ipkeys/eisscubeLTEhardware/kicad/Design-doc/EISScube v3.0 LTE 3D-front.jpg

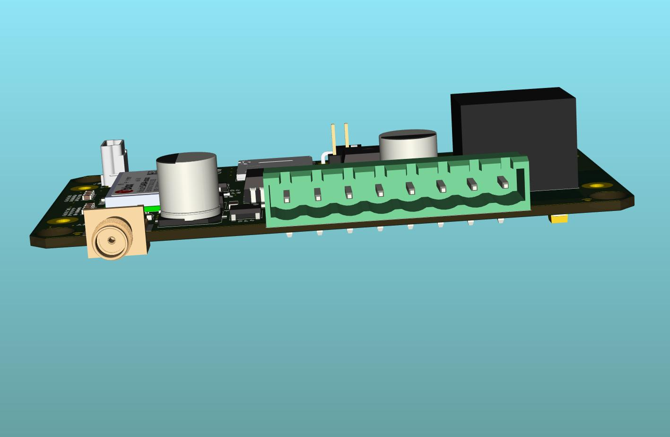
kicad/Design-doc/EISScube v3.0 LTE 3D-front.jpg
