ipkeys/eisscubeLTEhardware/README.md

# eisscubeLTEhardware
EISScube v3.0 LTE hardware design
