ipkeys/eisscubeLTEhardware/kicad/Design-doc/EISScube v3.0 LTE-BOM-case-connector.xlsx

Source: | EISScube v3.0 LTE.sch
Date: | Wednesday, April 18, 2018 'PMt' 01:15:05 PM
Tool: | Eeschema 4.0.7
Component Count: | 126
Ref | Qnty | Value | Footprint | Description
AE1, | 1 | Antenna_Shield | Connectors_Molex:Molex_SMA_Jack_Edge_Mount | SMA Jack (edge mount)
C1, C7, C8, C9, C10, C11, C6, C21, C18, C20, C31, | 11 | 104K | Capacitors_SMD:C_0603 | Unpolarized capacitor
C4, C5, C2, C3, | 4 | 220J | Capacitors_SMD:C_0603 | Unpolarized capacitor
C12, | 1 | 330J | Capacitors_SMD:C_0603 | Unpolarized capacitor
C13, | 1 | 270J | Capacitors_SMD:C_0603 | Unpolarized capacitor
C14, C15, | 2 | 150J | Capacitors_SMD:C_0603 | Unpolarized capacitor
C16, | 1 | 680J | Capacitors_SMD:C_0603 | Unpolarized capacitor
C17, | 1 | 103K | Capacitors_SMD:C_0603 | Unpolarized capacitor
C19, C39, C42, | 3 | 105K | Capacitors_SMD:C_0603 | Unpolarized capacitor
C27, C26, C22, C23, C24, C25, | 6 | 470J | Capacitors_SMD:C_0603 | Unpolarized capacitor
C28, | 1 | 220uF 35V | Capacitors_SMD:CP_Elec_10x10.5 | Polarised capacitor
C30, | 1 | 470uF 16V | Capacitors_SMD:CP_Elec_10x10.5 | Polarised capacitor
C32, C35, | 2 | 106K 16V | Capacitors_Tantalum_SMD:CP_Tantalum_Case-B_EIA-3528-21_Reflow | Polarised capacitor
C34, C37, C38, C40, C41, C43, | 6 | 106K 6V3 | Capacitors_Tantalum_SMD:CP_Tantalum_Case-A_EIA-3216-18_Reflow | Polarised capacitor
C36, C33, C29, | 3 | 105K | Capacitors_SMD:C_1206 | Unpolarized capacitor
D1, D2, D3, D4, D5, | 5 | blue | LEDs:LED_0603 | LED generic
D6, D7, D8, D9, D10, D11, D12, | 7 | VBUS05B1-SD0 | Diodes_SMD:D_0603 | ESD Suppressors / TVS Diodes BiSy Sngl Line 5.5V ESD Prot Diode 16kV
D14, | 1 | MBL104S | Diodes_SMD:Diode_Bridge_MBLS | Diode Bridge
D15, | 1 | B120-E3 | Diodes_SMD:D_SMA | Surface Mount Schottky Barrier Rectifier
D17, D13, D16, | 3 | red | LEDs:LED_0603 | LED generic
D18, | 1 | 1N4001 | Diodes_THT:D_DO-41_SOD81_P10.16mm_Horizontal | Diod generic
J1, | 1 | Boot | Pin_Headers:Pin_Header_Straight_1x02_Pitch2.54mm | Generic connector, single row, 01x02
J2, | 1 | UART | Pin_Headers:Pin_Header_Straight_1x03_Pitch2.54mm | Generic connector, single row, 01x03
J3, | 1 | JTag | Socket_Strips:Socket_Strip_Straight_1x05_Pitch2.54mm | Generic connector, single row, 01x05
J4, | 1 | SIM_Card_w_det_sw | EISScube_LTE:SIM_Card_Hirose_KP10S-SF-PEJ-812 | SIM Card push-push holder with detect switch
J5, | 1 | USB_B_Mini | EISScube_LTE:USB_Micro-B_Molex-5022370517_Vertical | USB Mini Type B connector
J6, | 1 | Screw_Terminal_01x08 | Connectors_Phoenix:PhoenixContact_MSTBA-G_08x5.08mm_Angled | Phoenix Contact MSTBA-G_08
K1, | 1 | SANYOU_SRD_Form_C | Relays_THT:Relay_SPDT_SANYOU_SRD_Series_Form_C | Relay Song Chuan 833H-1C-C-12VDC
L1, | 1 | 68nH | Inductors_SMD:L_0603 | Inductor generic
L2, | 1 | 39nH | Inductors_SMD:L_0603 | Inductor generic
L3, | 1 | 150uH | Inductors_SMD:L_10.4x10.4_H4.8 | Inductor power
Q3, Q4, Q2, Q5, | 4 | GSM3612PJZF | TO_SOT_Packages_SMD:SOT-23 | Transistor N-MOSFETwith substrate diode (general)
R1, | 1 | 100K | Resistors_SMD:R_0603 | Resistor generic
R2, | 1 | 1K | Resistors_SMD:R_1206 | Resistor generic
R3, | 1 | 510R | Resistors_SMD:R_0603 | Resistor generic
R6, | 1 | 240R | Resistors_SMD:R_0603 | Resistor generic
R7, R8, R9, R10, R11, R4, R21, R22, R27, R25, R20, R29, R28, | 13 | 1K | Resistors_SMD:R_0603 | Resistor generic
R12, R13, R14, | 3 | 10K | Resistors_SMD:R_0603 | Resistor generic
R16, | 1 | 470K | Resistors_SMD:R_0603 | Resistor generic
R24, R26, R23, R19, R18, R17, R15, | 7 | 0R | Resistors_SMD:R_0603 | Resistor generic
R30, | 1 | 30K | Resistors_SMD:R_0603 | Resistor generic
R31, | 1 | 15K | Resistors_SMD:R_0603 | Resistor generic
SW1, | 1 | Reset | Buttons_Switches_SMD:SW_SPST_PTS645 | Push button switch, generic, 4 pins
TP1, TP2, TP7, TP6, TP8, TP3, TP4, TP5, | 8 | Test_Point | Connectors_TestPoints:Test_Point_Pad_d1.0mm | test point
U1, | 1 | STM32L051C8Tx | Housings_QFP:LQFP-48_7x7mm_Pitch0.5mm | Core: ARM Cortex-M0+, Package: LQFP48, Flash: 32 kB, RAM: 8 kB, Frequency: 32 MHz, Voltage: 1.65..3.6V, I/O pins: 37
U2, | 1 | SN74LV1T34DBVR | TO_SOT_Packages_SMD:SOT-23-5 | Single Power Supply Single Buffer GATE CMOS Logic Level Shifter
U3, | 1 | U-Blox-SARA-R4 | EISScube_LTE:SARA-R4-96 | LTE Cat M1/NB1 and EGPRS modules - SARA-R410M-02B-00, SARA-R410M-01B-00, SARA-R404M-00B
U4, | 1 | LM2576HVS-12 | TO_SOT_Packages_SMD:TO-263-5_TabPin3 | TO-263, 12V 3A Step-Down VR High Voltage Input
U5, | 1 | MIC29302WU-TR | TO_SOT_Packages_SMD:TO-263-5_TabPin6 | High-Current Low Dropout Regulators
U6, | 1 | L7805 | TO_SOT_Packages_SMD:TO-252-2 | Positive 1.5A 35V Linear Regulator, Fixed Output 5V
U7, | 1 | LM1117-3.3 | TO_SOT_Packages_SMD:SOT-223-3_TabPin2 | 800mA Low-Dropout Linear Regulator, 3.3V fixed output
U8, | 1 | LM1117-1.8 | TO_SOT_Packages_SMD:SOT-223-3_TabPin2 | 800mA Low-Dropout Linear Regulator, 1.8V fixed output
U9, | 1 | LTV-357T | Housings_SOIC:SO-4_4.4x3.6mm_Pitch2.54mm | DC Optocoupler, Vce 80V, CTR 50%
Y1, | 1 | 12MHz | Crystals:Crystal_SMD_3225-4pin_3.2x2.5mm | Four pin crystal (GND on pins 2 and 4), e.g. in SMD package
Y2, | 1 | 32.768KHz | Crystals:Crystal_SMD_3215-2pin_3.2x1.5mm | Two pin crystal
External | 1 | Screw_Terminal_01x08 second part | PhoenixContact_MSTB 2,5/ 2-ST-5,08 | Plug component, Screw connection with tension sleeve Phoenix Contact MSTB 2-ST-5,08
External | 1 | Case | RITEC Enclosures - RL6015 | Clousure case (need to ask for customization - make a 4 holes in bottom part)
