ipkeys/eisscubeLTEhardware/kicad/Design-doc/EISScube v3.0 LTE-BOM.xlsx

Source: | /EISScube v3.0 LTE/EISScube v3.0 LTE.sch
Date: | Tuesday, April 03, 2018 'PMt' 01:28:19 PM
Tool: | Eeschema 4.0.7
Component Count: | 126 |  |  |  | Total: | 51.11
Ref | Qnty | Value | Cmp name | Vendor | Price (for 100 items) | Price for 1 board | Description
AE1, | 1 | Antenna_Shield | Antenna_Shield | Mouser Electronics | 2.67 | 2.67 | Antenna symbol with extra pin for shielding
C1, C7, C8, C9, C10, C11, C6, C21, C18, C20, C31, | 11 | 104K | C | Mouser Electronics | 0.03 | 0.33 | Unpolarized capacitor
C4, C5, C2, C3, | 4 | 220J | C | Mouser Electronics | 0.03 | 0.12 | Unpolarized capacitor
C12, | 1 | 330J | C | Mouser Electronics | 0.03 | 0.03 | Unpolarized capacitor
C13, | 1 | 270J | C | Mouser Electronics | 0.03 | 0.03 | Unpolarized capacitor
C14, C15, | 2 | 150J | C | Mouser Electronics | 0.03 | 0.06 | Unpolarized capacitor
C16, | 1 | 680J | C | Mouser Electronics | 0.03 | 0.03 | Unpolarized capacitor
C17, | 1 | 103K | C | Mouser Electronics | 0.02 | 0.02 | Unpolarized capacitor
C19, C39, C42, | 3 | 105K | C | Mouser Electronics | 0.03 | 0.09 | Unpolarized capacitor
C27, C26, C22, C23, C24, C25, | 6 | 470J | C | Mouser Electronics | 0.03 | 0.18 | Unpolarized capacitor
C28, | 1 | 470uF 35V | CP | Mouser Electronics | 0.52 | 0.52 | Polarised capacitor
C30, | 1 | 330uF 16V | CP | Mouser Electronics | 0.25 | 0.25 | Polarised capacitor
C32, C35 | 2 | 106K 16V | CP | Mouser Electronics | 1 | 2 | Polarised capacitor
C34, C37, C38, C40, C41, C43, | 6 | 106K 6V3 | CP | Mouser Electronics | 0.5 | 3 | Polarised capacitor
C29, C36, C33, | 3 | 105K | C | Mouser Electronics | 0.12 | 0.36 | Unpolarized capacitor
D1, D2, D3, D4, D5, | 5 | blue | LED | Mouser Electronics | 0.08 | 0.4 | LED generic
D6, D7, D8, D9, D10, D11, D12, | 7 | VBUS05B1-SD0 | VBUS05B1-SD0 | Mouser Electronics | 0.09 | 0.63 | ESD Suppressors / TVS Diodes BiSy Sngl Line 5.5V ESD Prot Diode 16kV
D14, | 1 | MBL104S | MBL104S | Mouser Electronics | 0.31 | 0.31
D15, | 1 | B120-E3 | B120-E3 | Mouser Electronics | 0.15 | 0.15
D17, D13, D16, | 3 | red | LED | Mouser Electronics | 0.08 | 0.24 | LED generic
D18, | 1 | 1N4001 | 1N4001 | Mouser Electronics | 0.25 | 0.25
J1, | 1 | Boot | Conn_01x02_Male | Mouser Electronics | 0.1 | 0.1 | Generic connector, single row, 01x02
J2, | 1 | UART | Conn_01x03_Male | Mouser Electronics | 0.1 | 0.1 | Generic connector, single row, 01x03
J3, | 1 | JTag | Conn_01x05_Female | Mouser Electronics | 0.1 | 0.1 | Generic connector, single row, 01x05
J4, | 1 | SIM_Card_w_det_sw | SIM_Card_w_det_sw | Mouser Electronics | 1.1 | 1.1 | SIM Card
J5, | 1 | USB_B_Mini | USB_B_Mini | Mouser Electronics | 2.26 | 2.26 | USB Mini Type B connector
J6, | 1 | Screw_Terminal_01x08 | Screw_Terminal_01x08 | Mouser Electronics | 2.5 | 2.5 | Generic screw terminal, single row, 01x08
K1, | 1 | SANYOU_SRD_Form_C | SANYOU_SRD_Form_C | Mouser Electronics | 1.5 | 1.5
L1, | 1 | 68nH | L | Mouser Electronics | 0.1 | 0.1 | Inductor
L2, | 1 | 39nH | L | Mouser Electronics | 0.1 | 0.1 | Inductor
L3, | 1 | 150uH | L | Mouser Electronics | 0.5 | 0.5 | Inductor
Q3, Q4, Q2, Q5, | 4 | GSM3612PJZF | Q_NMOS_GSD | Mouser Electronics | 0.1 | 0.4 | Transistor N-MOSFETwith substrate diode (general)
R1, | 1 | 100K | R | Mouser Electronics | 0.01 | 0.01 | Resistor
R2, | 1 | 1K | R | Mouser Electronics | 0.04 | 0.04 | Resistor
R3, | 1 | 510R | R | Mouser Electronics | 0.01 | 0.01 | Resistor
R6, | 1 | 240R | R | Mouser Electronics | 0.01 | 0.01 | Resistor
R7, R8, R9, R10, R11, R4, R21, R22, R27, R25, R20, R29, R28, | 13 | 1K | R | Mouser Electronics | 0.01 | 0.13 | Resistor
R12, R13, R14, | 3 | 10K | R | Mouser Electronics | 0.01 | 0.03 | Resistor
R16, | 1 | 470K | R | Mouser Electronics | 0.01 | 0.01 | Resistor
R24, R26, R23, R19, R18, R17, R15, | 7 | 0R | R | Mouser Electronics | 0.01 | 0.07 | Resistor
R30, | 1 | 30K | R | Mouser Electronics | 0.01 | 0.01 | Resistor
R31, | 1 | 15K | R | Mouser Electronics | 0.01 | 0.01 | Resistor
SW1, | 1 | Reset | SW_Push | Mouser Electronics | 0.2 | 0.2 | Push button switch, generic, two pins
TP1, TP2, TP7, TP6, TP8, TP3, TP4, TP5, | 8 | Test_Point | Test_Point | Mouser Electronics | 0 | 0 | test point
U1, | 1 | STM32L051C8Tx | STM32L051C8Tx | Mouser Electronics | 1.75 | 1.75 | Core: ARM Cortex-M0+, Package: LQFP48, Flash: 32 kB, RAM: 8 kB, Frequency: 32 MHz, Voltage: 1.65..3.6V, I/O pins: 37
U2, | 1 | SN74LV1T34DBVR | SN74LV1T34DBVR | Mouser Electronics | 0.2 | 0.2 | Single Power Supply Single Buffer GATE CMOS Logic Level Shifter
U3, | 1 | U-Blox-SARA-R4 | U-Blox-SARA-R4 | Mouser Electronics | 17 | 17 | Size-optimized LTE Cat M1/NB1 and EGPRS modules
U4, | 1 | LM2576HVS-12 | LM2576HVS-12 | Mouser Electronics | 6.5 | 6.5 | TO-263, 12V 3A Step-Down VR High Voltage Input
U5, | 1 | MIC29302WU-TR | MIC29302WU-TR | Mouser Electronics | 2.2 | 2.2
U6, | 1 | L7805 | L7805 | Mouser Electronics | 0.5 | 0.5 | Positive 1.5A 35V Linear Regulator, Fixed Output 5V, TO-220/TO-263/TO-252
U7, | 1 | LM1117-3.3 | LM1117-3.3 | Mouser Electronics | 0.5 | 0.5 | 800mA Low-Dropout Linear Regulator, 1.8V fixed output, TO-220/TO-252/TO-263/SOT-223
U8, | 1 | LM1117-1.8 | LM1117-1.8 | Mouser Electronics | 0.5 | 0.5 | 800mA Low-Dropout Linear Regulator, 1.8V fixed output, TO-220/TO-252/TO-263/SOT-223
U9, | 1 | LTV-357T | LTV-357T | Mouser Electronics | 0.5 | 0.5 | DC Optocoupler, Vce 80V, CTR 50%, SO-4
Y1, | 1 | 12MHz | Crystal_GND24 | Mouser Electronics | 0.3 | 0.3 | Four pin crystal (GND on pins 2 and 4), e.g. in SMD package
Y2, | 1 | 32.768KHz | Crystal | Mouser Electronics | 0.2 | 0.2 | Two pin crystal
