ipkeys/eisscubeLTEhardware/3D/RL6015 w1 151029.STEP

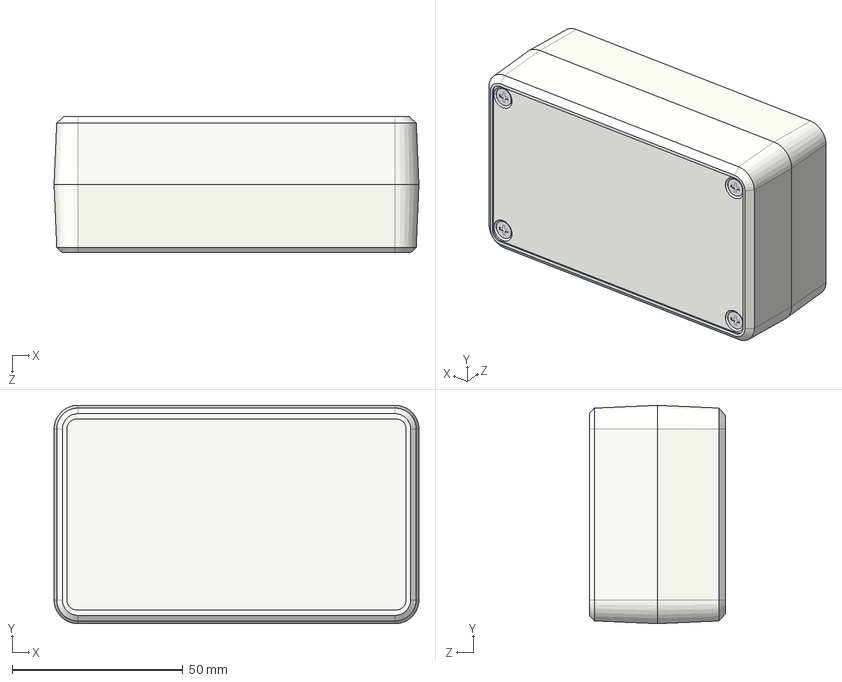
[picture p7: CAD file, 2018-05-07]
3D/RL6015 w1 151029.STEP
107.0 x 64.0 x 40.0 mm
6015B v1
6015T v1
FLAT M3-25-Self v2 x 4
M3x6-pan self x 4
