ipkeys/eisscubeLTEhardware/kicad/EISScube_v3_0_LTE.FCStd

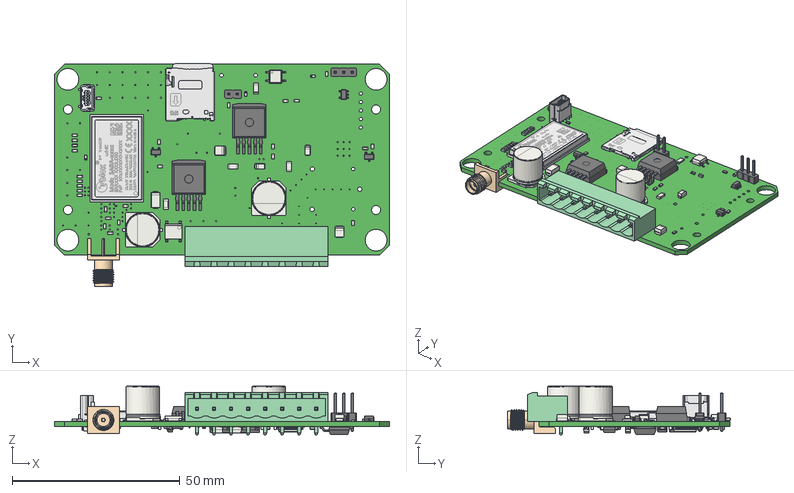
[picture p8: CAD file, 2018-05-07]
kicad/EISScube_v3_0_LTE.FCStd
100.0 x 66.4 x 14.5 mm
Pcb
R_0603_
C_0603_
C_1206_
C_1206_001
MSTBA_01x08_G_5_08mm_
Molex_SMA_Jack_Edge_Mount-732511150_
C_0603_001
C_0603_006
C_0603_008
C_0603_012
C_0603_013
C_0603_014
C_0603_015
C_0603_016
C_0603_017
C_0603_018
C_0603_021
C_0603_022
C_0603_023
C_0603_024
Diode_Bridge_Vishay_MBLS_
D_SMA_
L_0603_
L_0603_001
SOT_23_002
SOT_23_003
R_0603_001
R_0603_002
R_0603_003
R_0603_010
R_0603_014
R_0603_022
R_0603_024
R_0603_025
R_0603_026
R_0603_027
R_0603_028
SOT_23_5_
TO_263_5_TabPin3_
TO_263_5_TabPin6_
CP_Elec_10x10.5_
CP_Elec_10x10.5_001
C_0603_027
CP_Tantalum_Case-A_EIA-3216-18_001
CP_Tantalum_Case-A_EIA-3216-18_002
Pin_Header_Straight_1x02_Pitch254mm_
Pin_Header_Straight_1x03_Pitch254mm_
CP_Tantalum_Case-B_EIA-3528-21_
SOP_4_38x41mm_P254mm_
R_1206_
USB_Micro_B_Molex_5022370517_Vertical_
KP10S_SF_PEJ_4800324012_3D_
SARA_R4_
C_1206_002
CP_Tantalum_Case-B_EIA-3528-21_001
L_0201_
CP_Tantalum_Case-A_EIA-3216-18_
C_0603_002
C_0603_003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
