ipkeys/eisscubeLTEhardware/3D/RL6015.FCStd

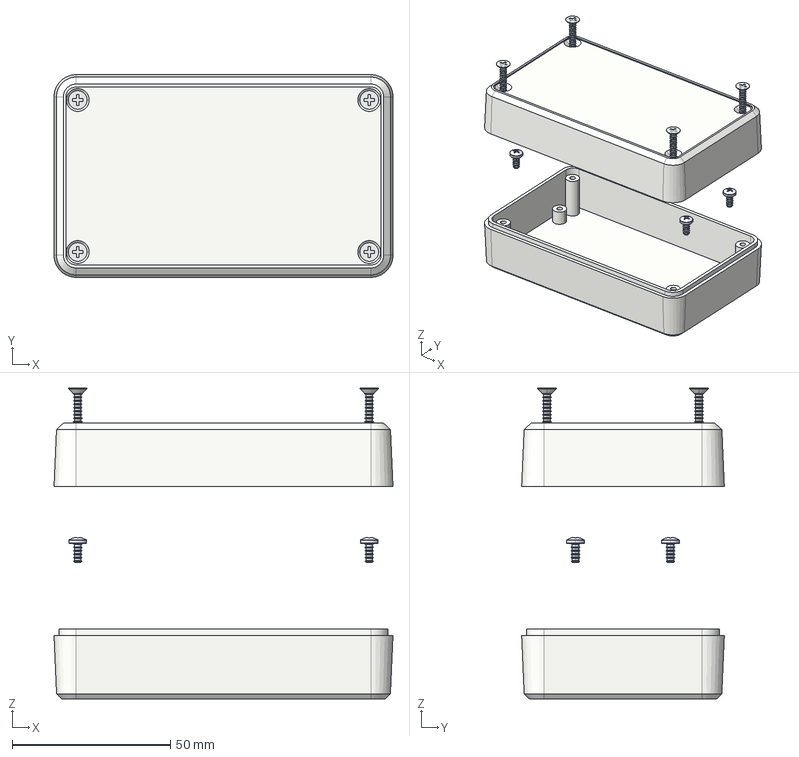
[picture p9: CAD file, 2018-05-07]
3D/RL6015.FCStd
107.0 x 64.0 x 98.1 mm
6015B v1
6015T v1
FLAT M3-25-Self v2
M3x6-pan self
M3x6-pan self001
FLAT M3-25-Self v003
M3x6-pan self002
FLAT M3-25-Self v004
M3x6-pan self003
FLAT M3-25-Self v005
