ipkeys/eisscubeLTEhardware/kicad/Design-doc/EISScube v3.0 LTE-btm-assembly.pdf

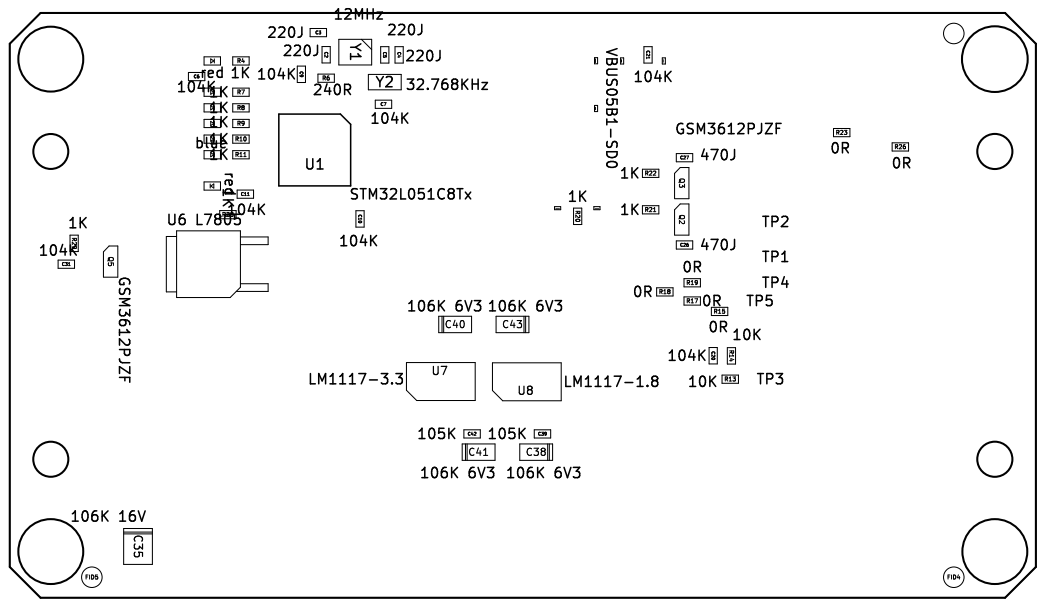
[picture p10: page 1]
