ipkeys/eisscubeLTEhardware/kicad/Design-doc/EISScube v3.0 LTE-top-assembly.pdf

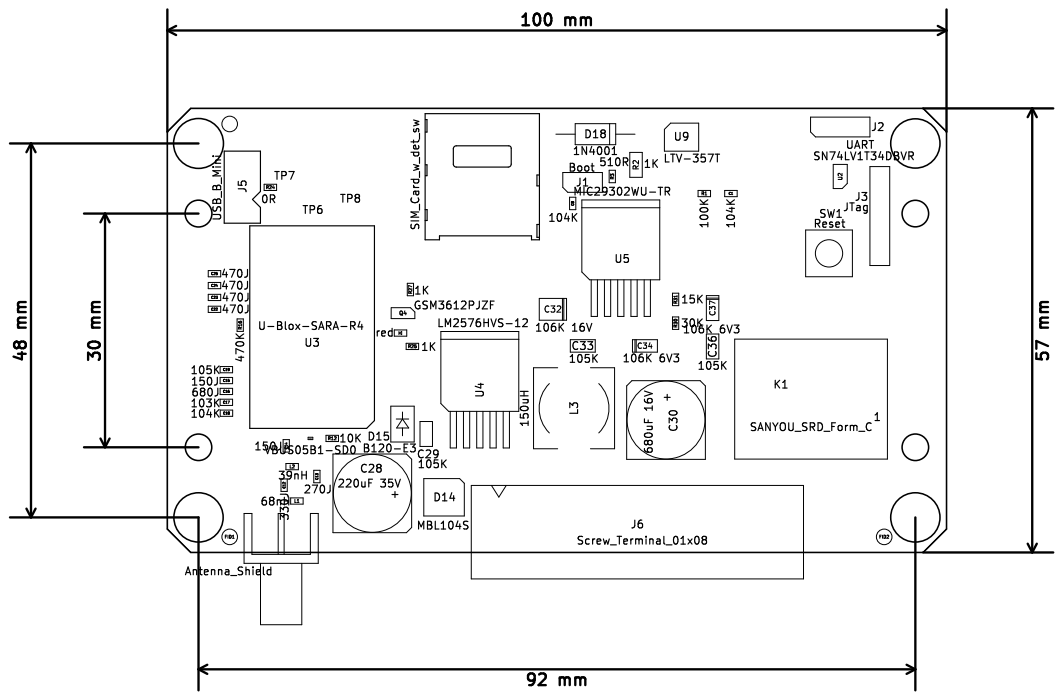
[picture p11: page 1]
