ipkeys/eisscubeLTEhardware/kicad/Design-doc/EISScube v3.0 LTE-schematic.pdf

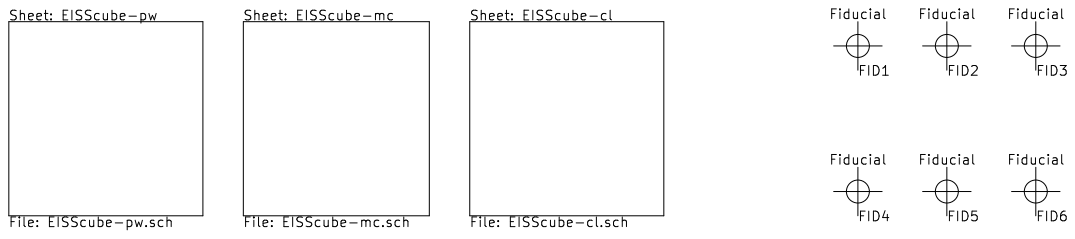
[picture p12: page 1]

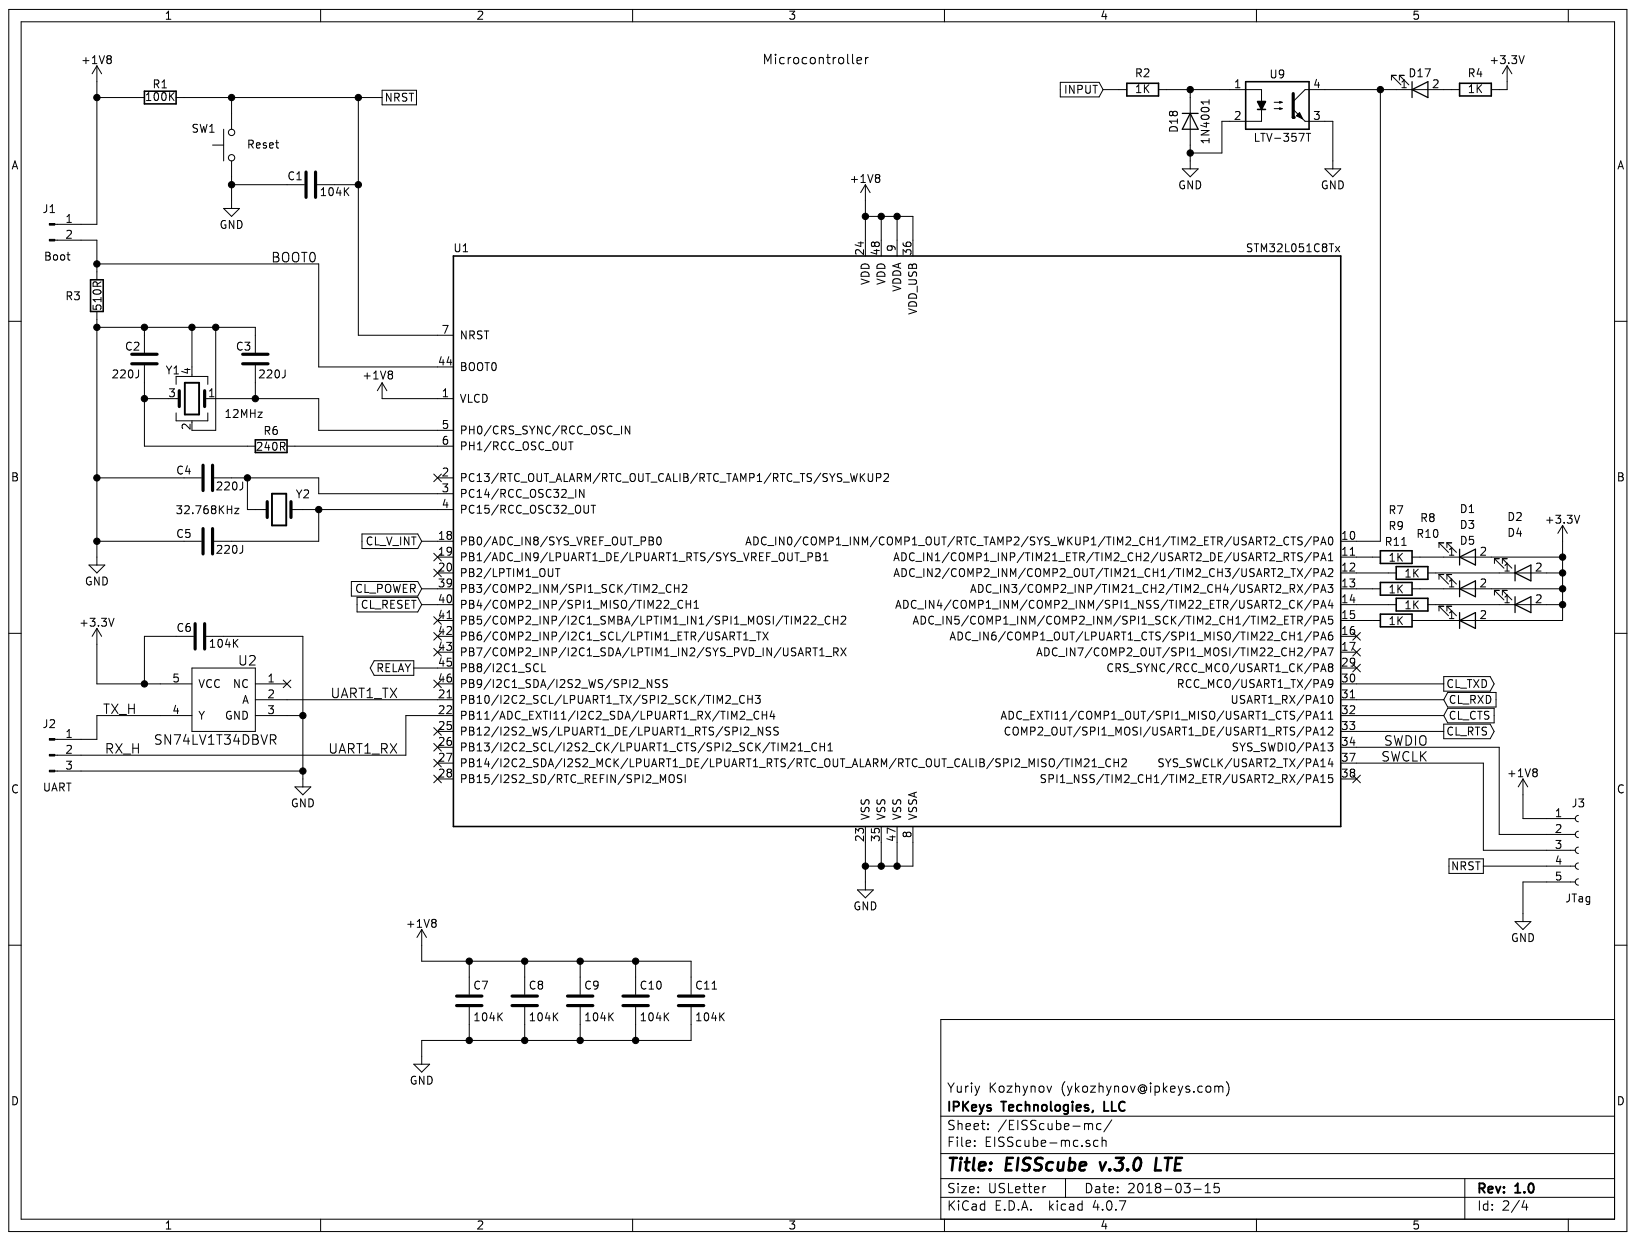
[picture p13: page 2]

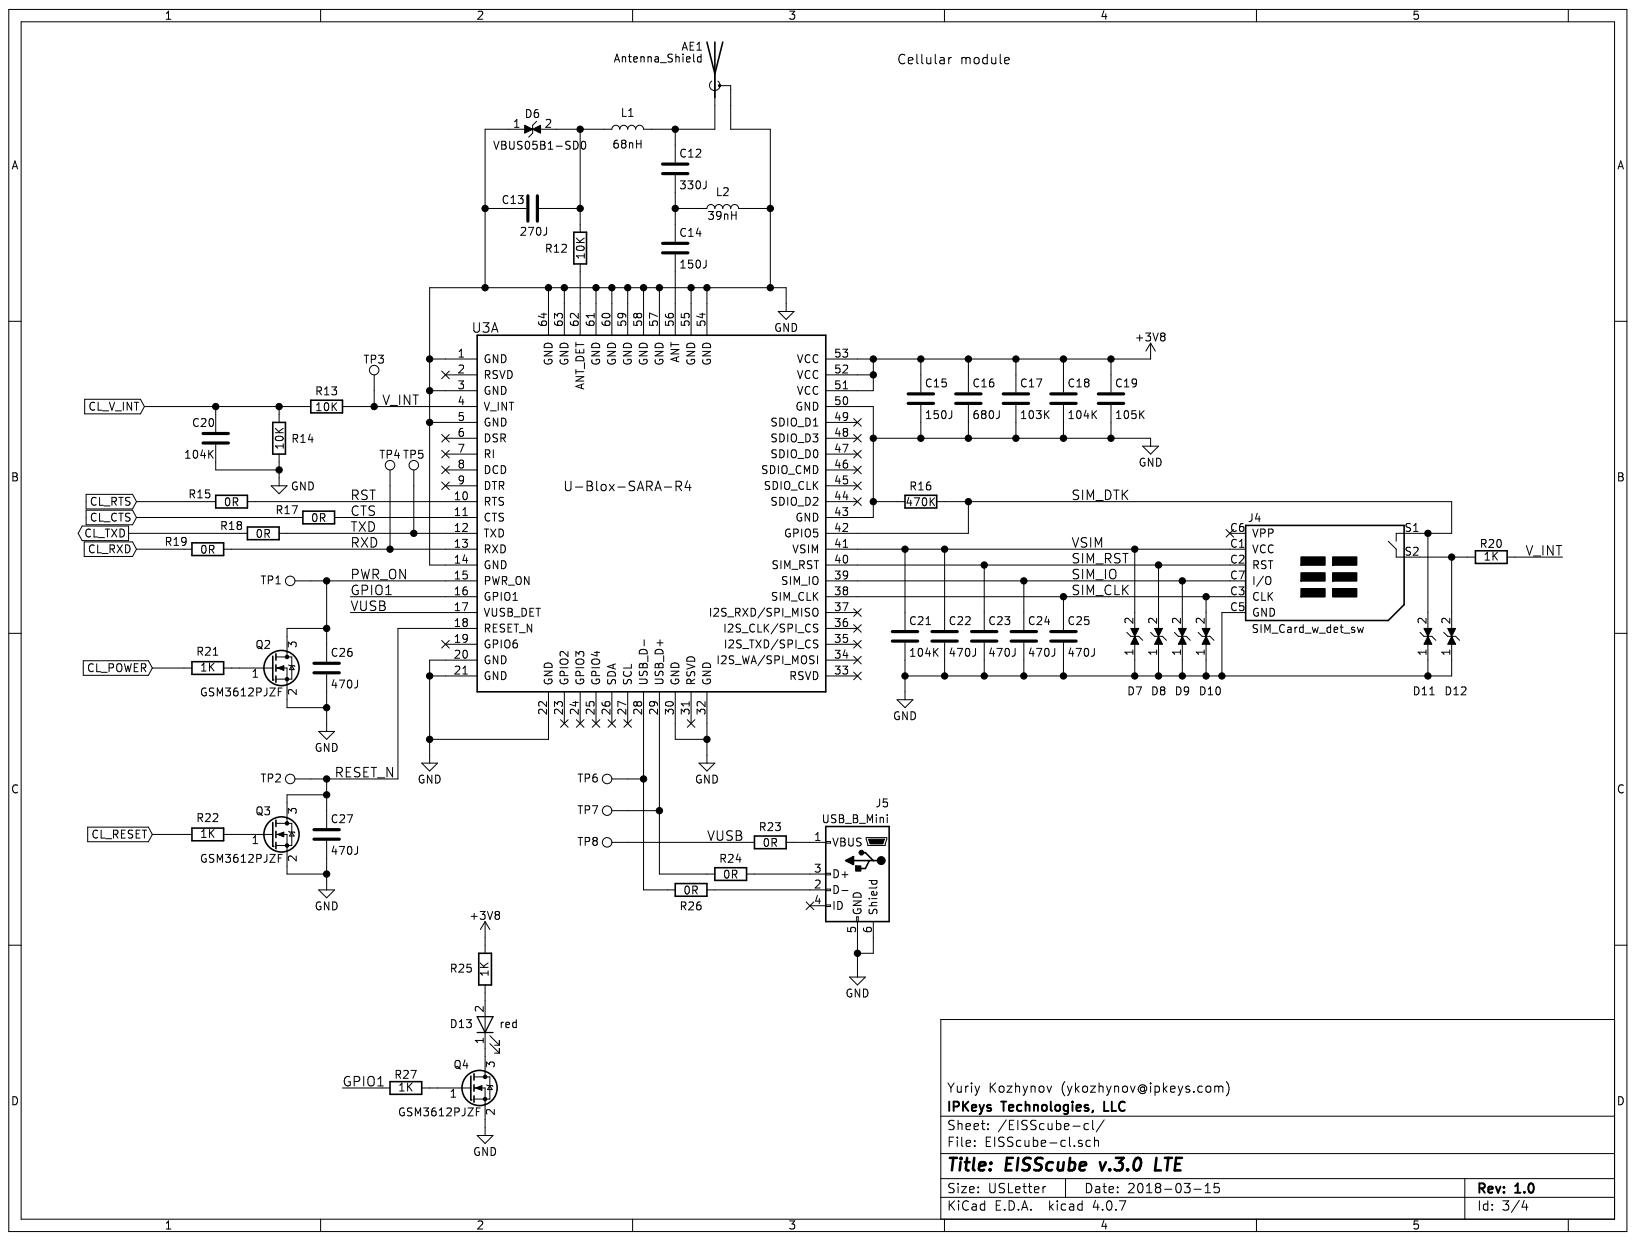
[picture p14: page 3]

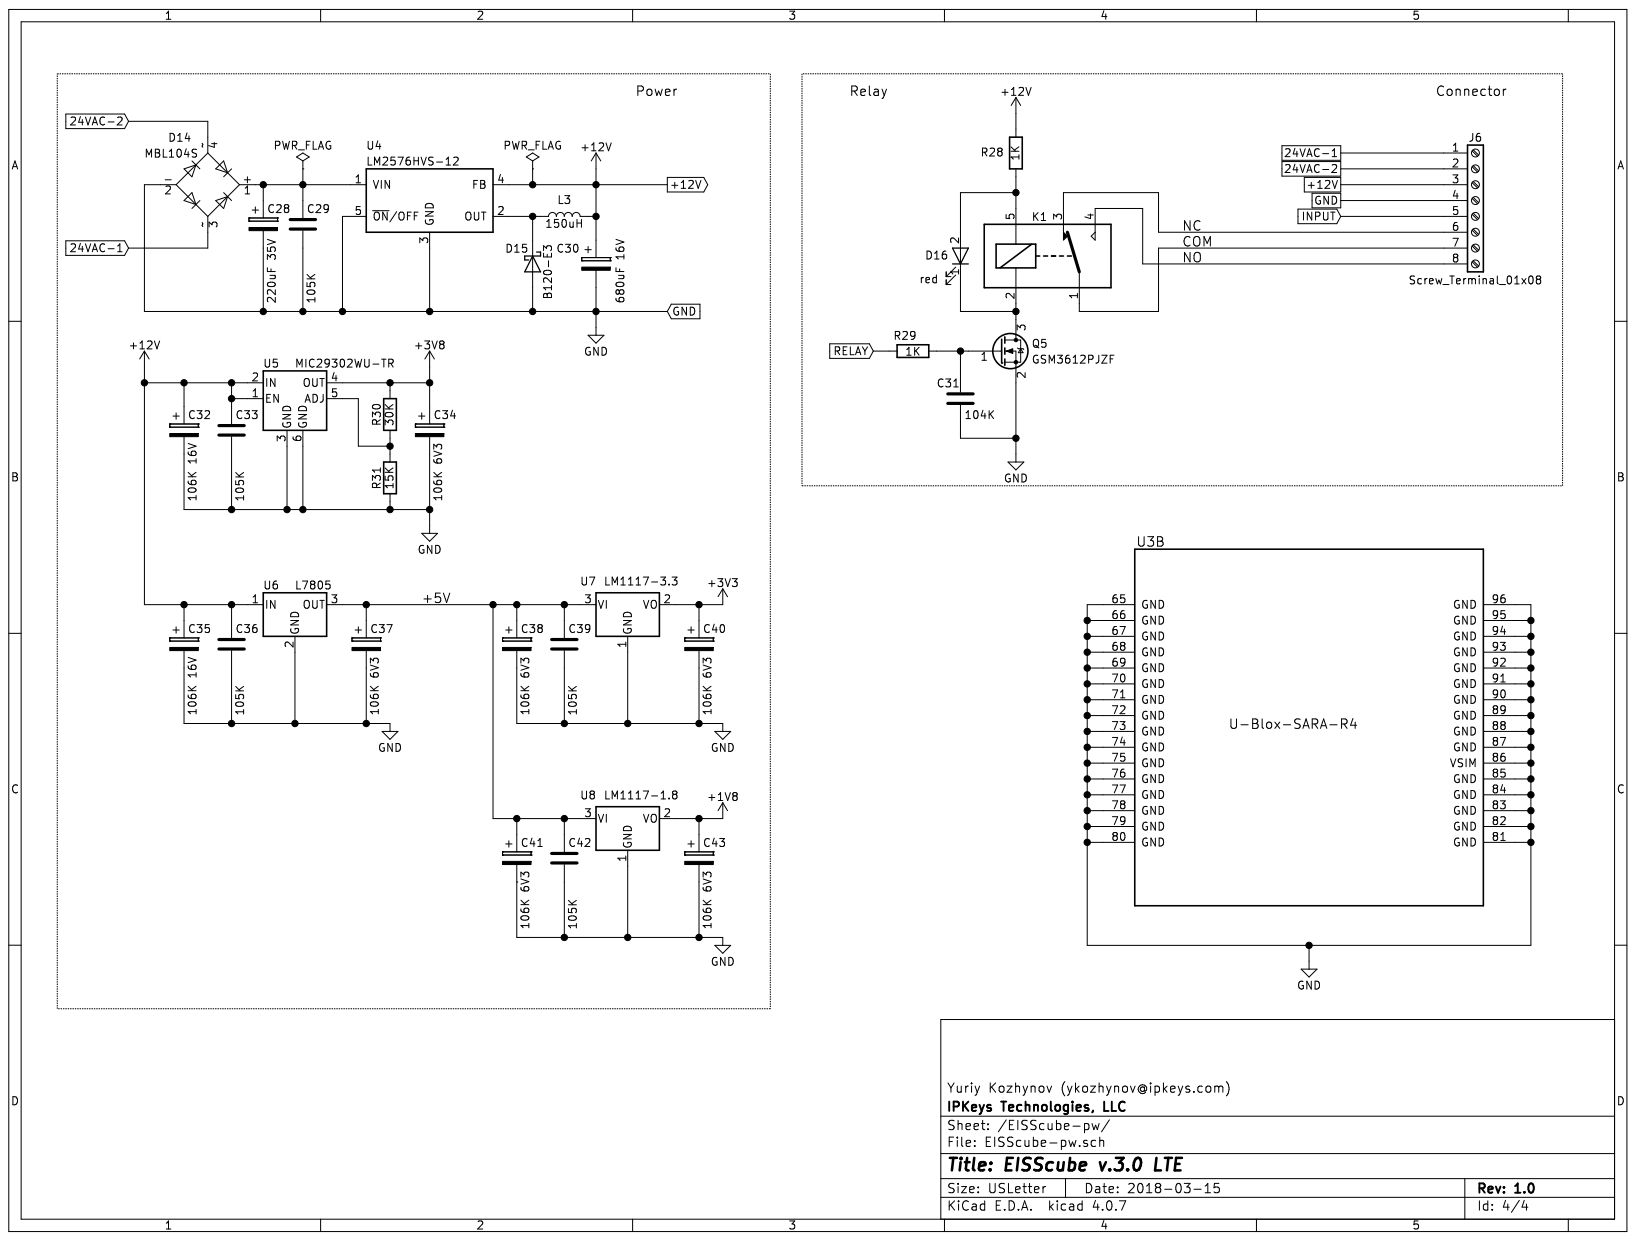
[picture p15: page 4]
