ipkeys/eisscubeLTEhardware/kicad/Docs/Molex-USB-5022370517.pdf

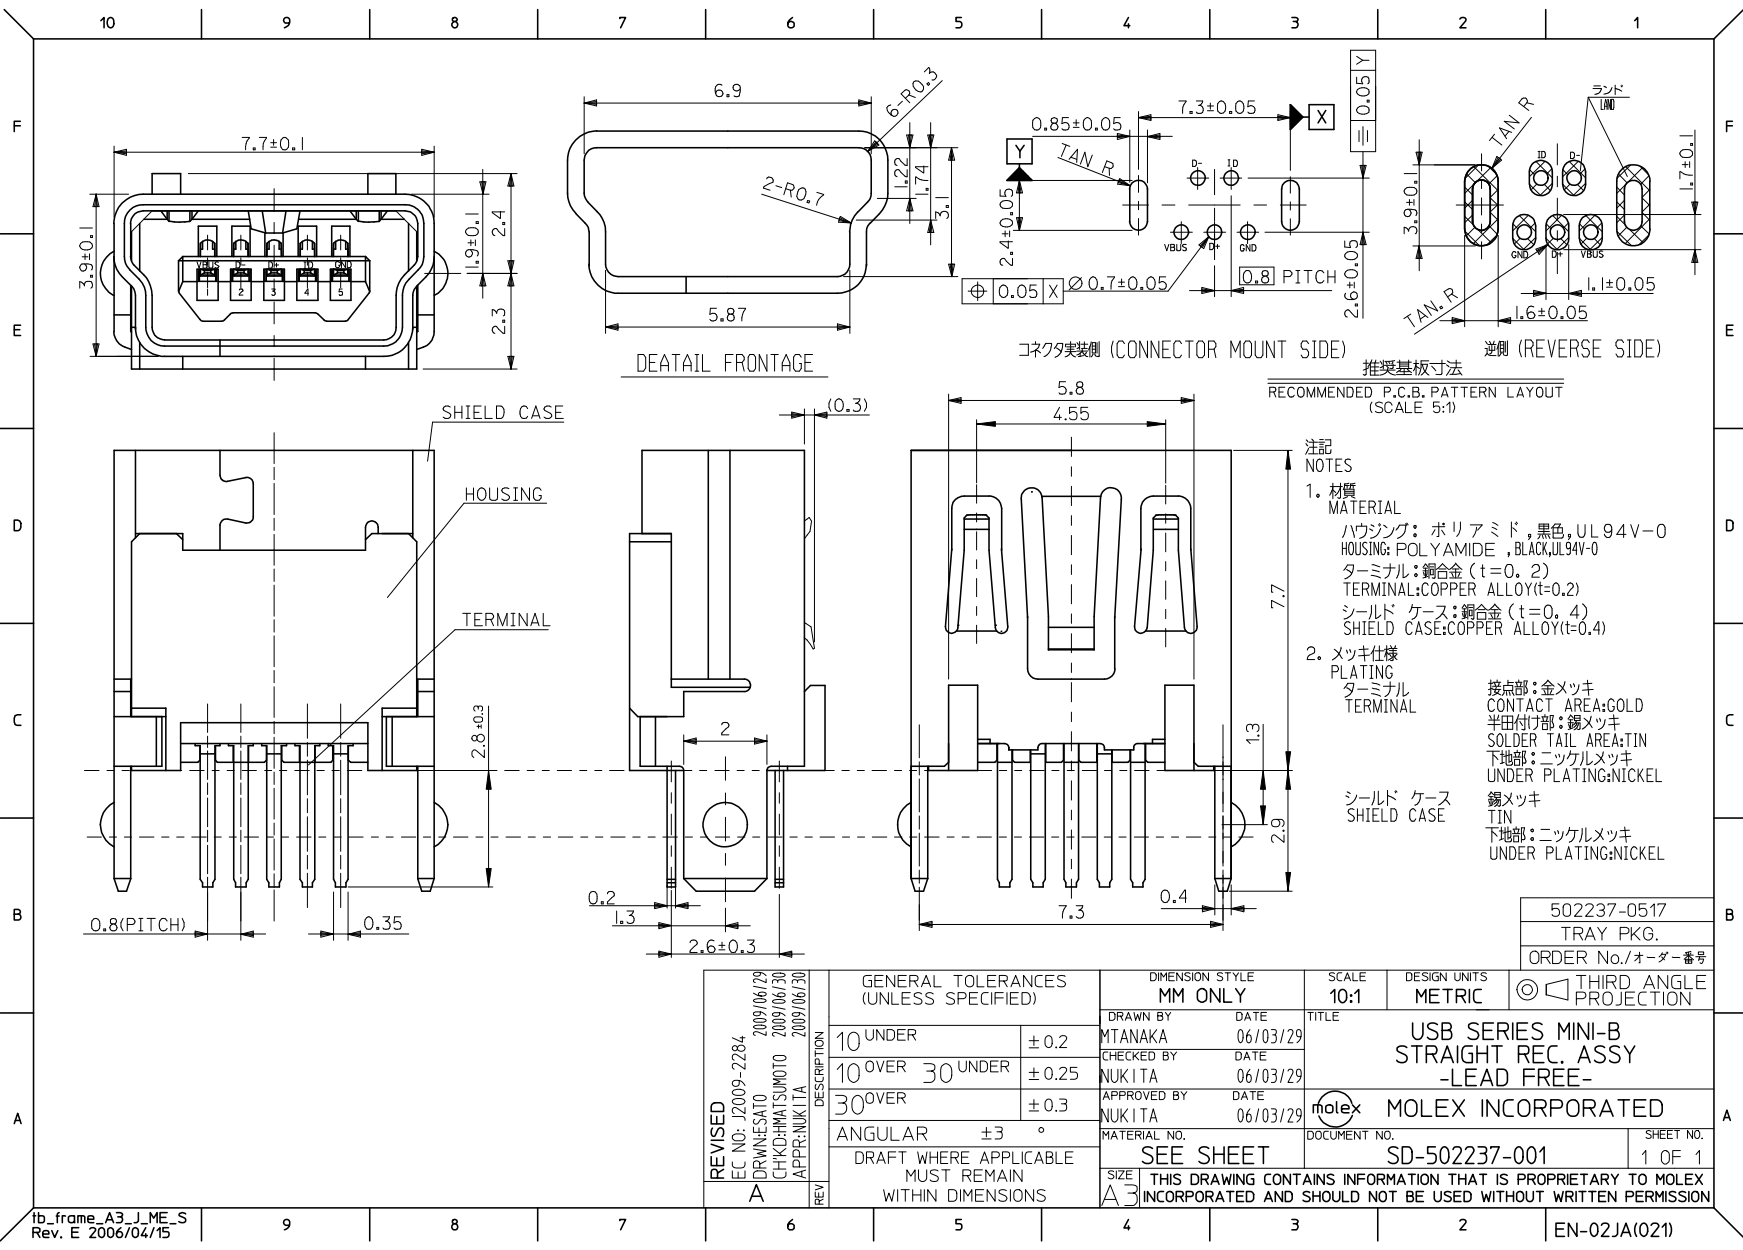
[picture p16: page 1]

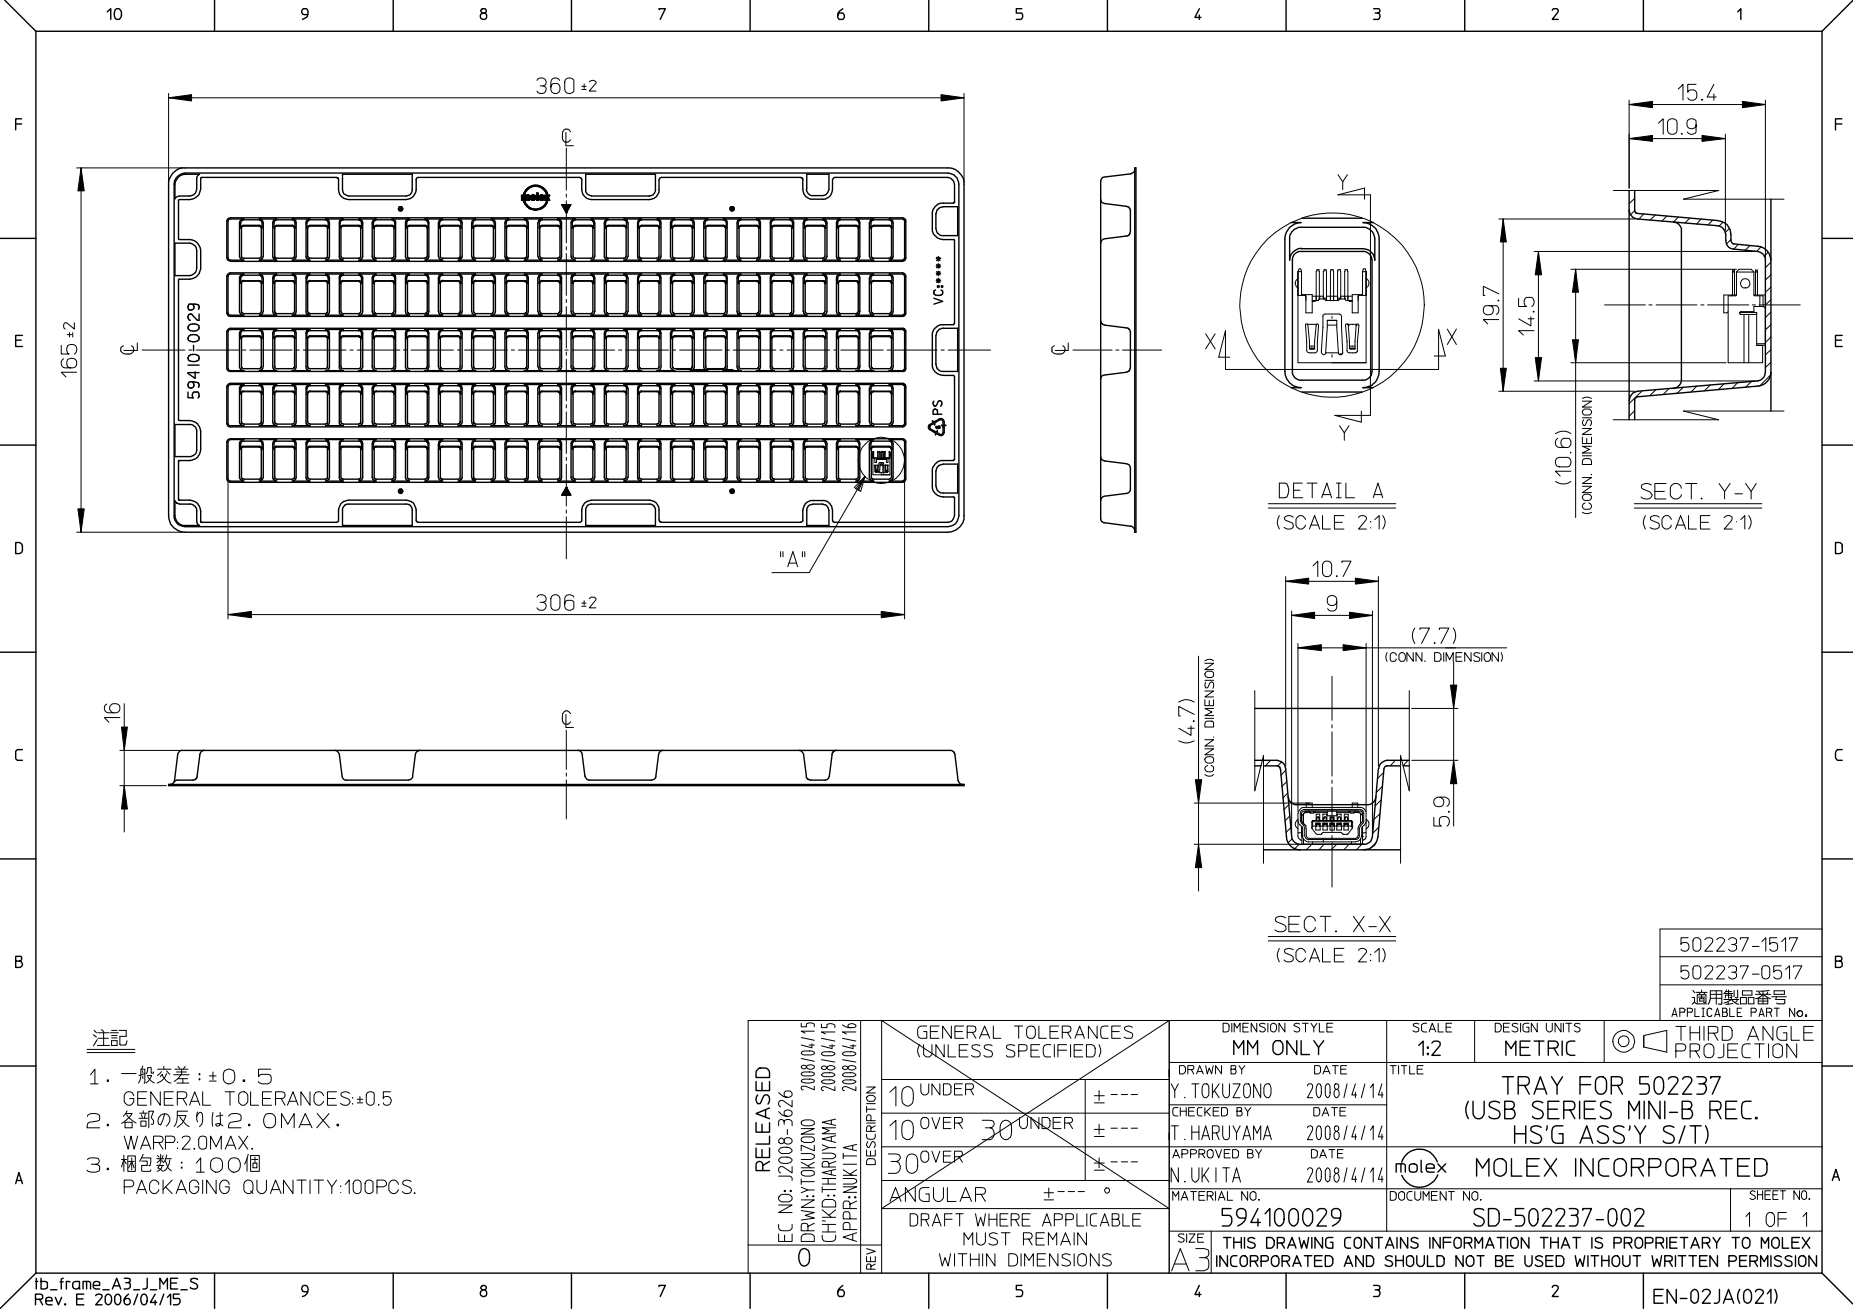
[picture p17: page 2]
