ipkeys/eisscubeLTEhardware/kicad/EISScube v3.0 LTE.kicad_pcb

## KiCad design kicad/EISScube v3.0 LTE.kicad_pcb (2018-05-08)

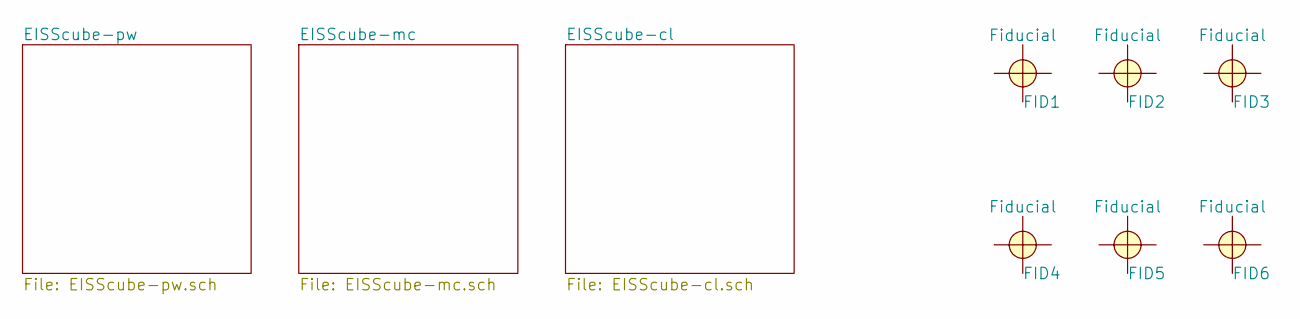
[picture p18: schematic EISScube v3.0 LTE.sch, EISScube v.3.0 LTE]

Parts:
FID1, FID2, FID3: Fiducial; Fiducial_1mm_Dia_2.54mm_Outer_CopperTop
FID4, FID5, FID6: Fiducial; Fiducial_1mm_Dia_2.54mm_Outer_CopperBottom

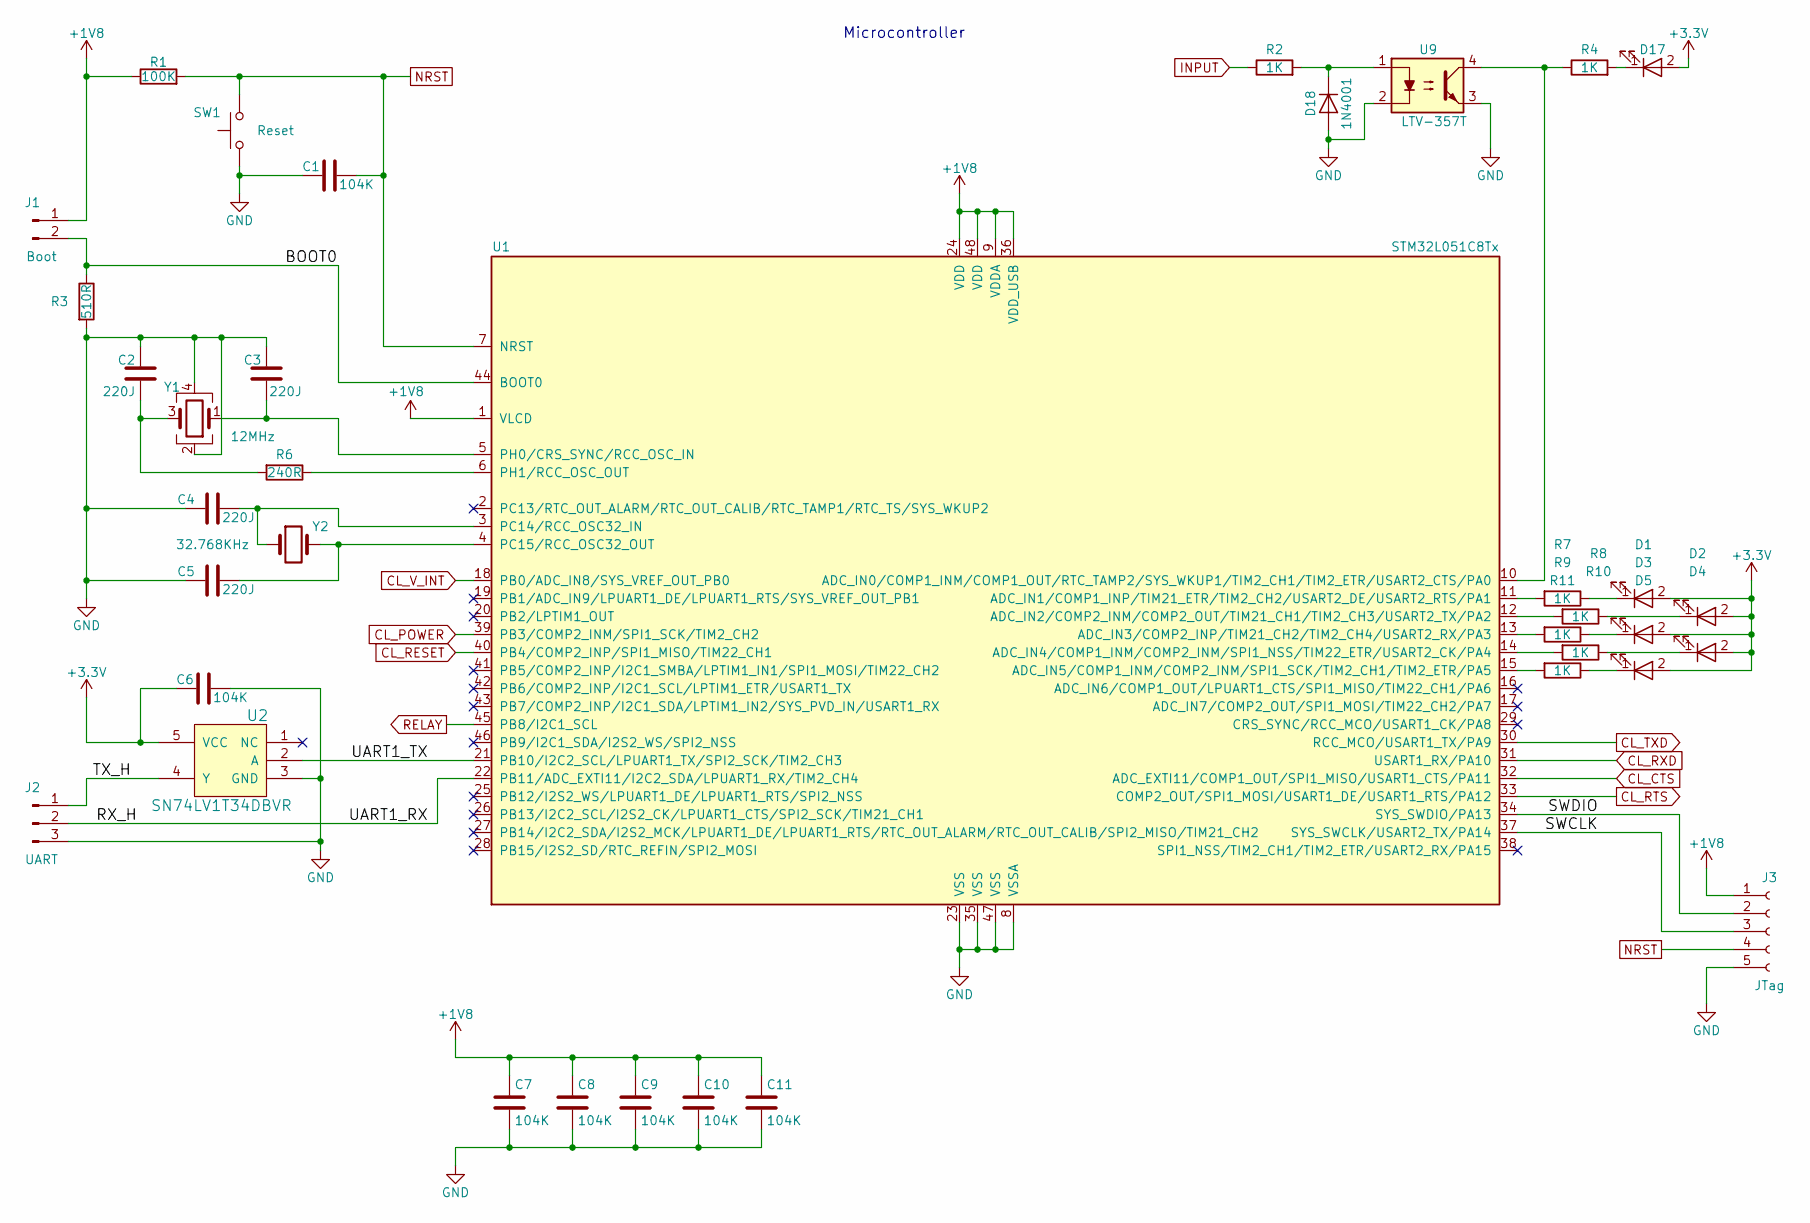
[picture p19: schematic EISScube-mc.sch, EISScube v.3.0 LTE]

Parts:
C1, C6, C7, C8, C9, C10, C11: 104K; C_0603
C2, C3, C4, C5: 220J; C_0603
D1, D2, D3, D4, D5: blue; LED_0603
D17: red; LED_0603
D18: 1N4001; D_DO-41_SOD81_P10.16mm_Horizontal
J1: Boot; Pin_Header_Straight_1x02_Pitch2.54mm
J2: UART; Pin_Header_Straight_1x03_Pitch2.54mm
J3: JTag; Socket_Strip_Straight_1x05_Pitch2.54mm
R1: 100K; R_0603
R2: 1K; R_1206
R3: 510R; R_0603
R4, R7, R8, R9, R10, R11: 1K; R_0603
R6: 240R; R_0603
SW1: Reset; SW_SPST_PTS645
U1: STM32L051C8Tx; LQFP-48_7x7mm_Pitch0.5mm
U2: SN74LV1T34DBVR; SOT-23-5
U9: LTV-357T; SO-4_4.4x3.6mm_Pitch2.54mm
Y1: 12MHz; Crystal_SMD_3225-4pin_3.2x2.5mm
Y2: 32.768KHz; Crystal_SMD_3215-2pin_3.2x1.5mm

Connections:
+1V8: C7.1, C8.1, C9.1, C10.1, C11.1, J1.1, J3.1, R1.1, U1.1 (VLCD), U1.9 (VDDA), U1.24 (VDD), U1.36 (VDD_USB), U1.48 (VDD); also elsewhere on the board
/EISScube-mc/BOOT0: J1.2, R3.1, U1.44 (BOOT0)
/EISScube-mc/RX_H: J2.2, U1.22 (PB11/ADC_EXTI11/I2C2_SDA/LPUART1_RX/TIM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)
/EISScube-mc/SWCLK: J3.3, U1.37 (SYS_SWCLK/USART2_TX/PA14)
/EISScube-mc/SWDIO: J3.2, U1.34 (SYS_SWDIO/PA13)
/EISScube-mc/TX_H: J2.1, U2.4 (Y)
/EISScube-mc/UART1_TX: U1.21 (PB10/I2C2_SCL/LPUART1_TX/SPI2_SCK/TIM2_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), U2.2 (A)
CL_CTS: U1.32 (ADC_EXTI11/COMP1_OUT/SPI1_MISO/USART1_C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); also elsewhere on the board
CL_POWER: U1.39 (PB3/COMP2_INM/SPI1_SCK/TIM2_CH2); also elsewhere on the board
CL_RESET: U1.40 (PB4/COMP2_INP/SPI1_MISO/TIM22_CH1); also elsewhere on the board
CL_RTS: U1.33 (COMP2_OUT/SPI1_MOSI/USART1_DE/USART1_RT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); also elsewhere on the board
CL_RXD: U1.31 (USART1_RX/PA10); also elsewhere on the board
CL_TXD: U1.30 (RCC_MCO/USART1_TX/PA9); also elsewhere on the board
CL_V_INT: U1.18 (PB0/ADC_IN8/SYS_VREF_OUT_PB0); also elsewhere on the board
GND: C1.1, C2.2, C3.2, C4.2, C5.2, C6.2, C7.2, C8.2, C9.2, C10.2, C11.2, D18.2 (A), J2.3, J3.5, R3.2, SW1.1, U1.8 (VSSA), U1.23 (VSS), U1.35 (VSS), U1.47 (VSS), U2.3 (GND), U9.2, U9.3, Y1.2, Y1.4; also elsewhere on the board
INPUT: R2.1; also elsewhere on the board
NRST: C1.2, J3.4, R1.2, SW1.2, U1.7 (NRST)
unnamed: C2.1, R6.2, Y1.3
unnamed: C3.1, U1.5 (PH0/CRS_SYNC/RCC_OSC_IN), Y1.1
unnamed: C4.1, U1.3 (PC14/RCC_OSC32_IN), Y2.1
unnamed: C5.1, U1.4 (PC15/RCC_OSC32_OUT), Y2.2
unnamed: D1.1 (K), R7.1
unnamed: D2.1 (K), R8.1
unnamed: D3.1 (K), R9.1
unnamed: D4.1 (K), R10.1
unnamed: D5.1 (K), R11.1
unnamed: D17.1 (K), R4.2
unnamed: D18.1 (K), R2.2, U9.1
unnamed: R4.1, U1.10 (ADC_IN0/COMP1_INM/COMP1_OUT/RTC_TAMP2/S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), U9.4
unnamed: R6.1, U1.6 (PH1/RCC_OSC_OUT)
unnamed: R7.2, U1.11 (ADC_IN1/COMP1_INP/TIM21_ETR/TIM2_CH2/US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)
unnamed: R8.2, U1.12 (ADC_IN2/COMP2_INM/COMP2_OUT/TIM21_CH1/T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)
unnamed: R9.2, U1.13 (ADC_IN3/COMP2_INP/TIM21_CH2/TIM2_CH4/US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)
unnamed: R10.2, U1.14 (ADC_IN4/COMP1_INM/COMP2_INM/SPI1_NSS/TI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)
unnamed: R11.2, U1.15 (ADC_IN5/COMP1_INM/COMP2_INM/SPI1_SCK/TI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)
RELAY: U1.45 (PB8/I2C1_SCL); also elsewhere on the board

Notes on the sheet:
Microcontroller

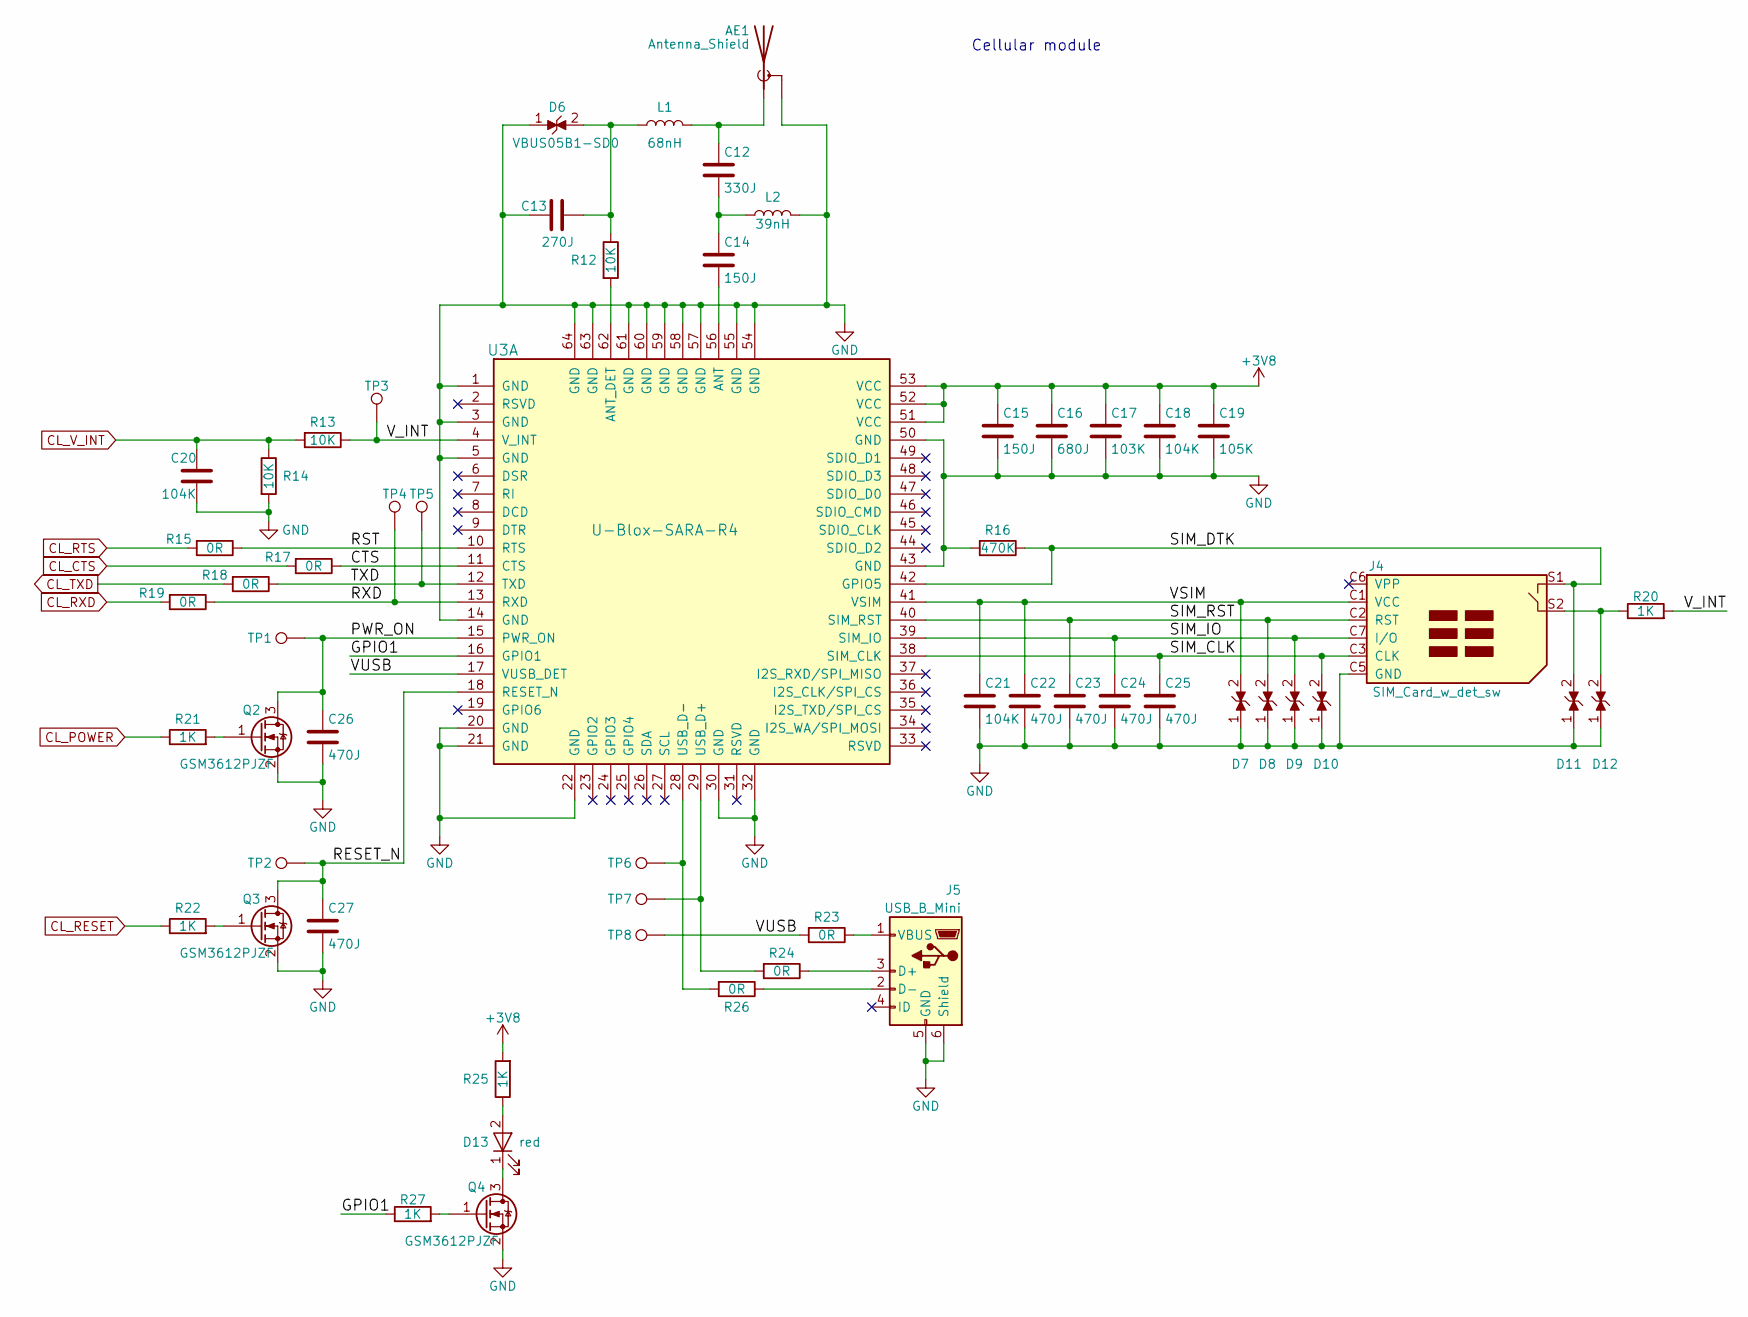
[picture p20: schematic EISScube-cl.sch, EISScube v.3.0 LTE]

Parts:
AE1: Antenna_Shield; Molex_SMA_Jack_Edge_Mount
C12: 330J; C_0603
C13: 270J; C_0603
C14, C15: 150J; C_0603
C16: 680J; C_0603
C17: 103K; C_0603
C18, C20, C21: 104K; C_0603
C19: 105K; C_0603
C22, C23, C24, C25, C26, C27: 470J; C_0603
D6, D7, D8, D9, D10, D11, D12: VBUS05B1-SD0; L_0201
D13: red; LED_0603
J4: SIM_Card_w_det_sw; SIM_Card_Hirose_KP10S-SF-PEJ-812
J5: USB_B_Mini; USB_Micro-B_Molex-5022370517_Vertical
L1: 68nH; L_0603
L2: 39nH; L_0603
Q2, Q3, Q4: GSM3612PJZF; SOT-23
R12, R13, R14: 10K; R_0603
R15, R17, R18, R19, R23, R24, R26: 0R; R_0603
R16: 470K; R_0603
R20, R21, R22, R25, R27: 1K; R_0603
TP1, TP2, TP3, TP4, TP5, TP6, TP7, TP8: Test_Point; Test_Point_Pad_d1.0mm
U3: U-Blox-SARA-R4; SARA-R4-96

Connections:
+3V8: C15.1, C16.1, C17.1, C18.1, C19.1, R25.2, U3.51 (VCC), U3.52 (VCC), U3.53 (VCC); also elsewhere on the board
/EISScube-cl/CTS: R17.1, U3.11 (CTS)
/EISScube-cl/GPIO1: R27.1, U3.16 (GPIO1)
/EISScube-cl/PWR_ON: C26.1, Q2.3 (D), TP1.1, U3.15 (PWR_ON)
/EISScube-cl/RESET_N: C27.1, Q3.3 (D), TP2.1, U3.18 (RESET_N)
/EISScube-cl/RST: R15.1, U3.10 (RTS)
/EISScube-cl/RXD: R19.1, TP4.1, U3.13 (RXD)
/EISScube-cl/SIM_CLK: C25.1, D10.2, J4.C3 (CLK), U3.38 (SIM_CLK)
/EISScube-cl/SIM_DTK: D11.2, J4.S1, R16.1, U3.42 (GPIO5)
/EISScube-cl/SIM_IO: C24.1, D9.2, J4.C7 (I/O), U3.39 (SIM_IO)
/EISScube-cl/SIM_RST: C23.1, D8.2, J4.C2 (RST), U3.40 (SIM_RST)
/EISScube-cl/TXD: R18.1, TP5.1, U3.12 (TXD)
/EISScube-cl/VSIM: C21.1, C22.1, D7.2, J4.C1 (VCC), U3.41 (VSIM)
/EISScube-cl/VUSB: R23.2, TP8.1, U3.17 (VUSB_DET)
/EISScube-cl/V_INT: R13.1, R20.2, TP3.1, U3.4 (V_INT)
CL_CTS: R17.2; also elsewhere on the board
CL_POWER: R21.1; also elsewhere on the board
CL_RESET: R22.1; also elsewhere on the board
CL_RTS: R15.2; also elsewhere on the board
CL_RXD: R19.2; also elsewhere on the board
CL_TXD: R18.2; also elsewhere on the board
CL_V_INT: C20.1, R13.2, R14.1; also elsewhere on the board
GND: AE1.2 (Shield), C13.1, C15.2, C16.2, C17.2, C18.2, C19.2, C20.2, C21.2, C22.2, C23.2, C24.2, C25.2, C26.2, C27.2, D6.1, D7.1, D8.1, D9.1, D10.1, D11.1, D12.1, J4.C5 (GND), J5.5 (GND), J5.6 (Shield), L2.2, Q2.2 (S), Q3.2 (S), Q4.2 (S), R14.2, R16.2, U3.1 (GND), U3.3 (GND), U3.5 (GND), U3.14 (GND), U3.20 (GND), U3.21 (GND), U3.22 (GND), U3.30 (GND), U3.32 (GND), U3.43 (GND), U3.50 (GND), U3.54 (GND), U3.55 (GND), U3.57 (GND), U3.58 (GND), U3.59 (GND), U3.60 (GND), U3.61 (GND), U3.63 (GND), U3.64 (GND); also elsewhere on the board
unnamed: AE1.1 (A), C12.1, L1.2
unnamed: C12.2, C14.1, L2.1
unnamed: C13.2, D6.2, L1.1, R12.1
unnamed: C14.2, U3.56 (ANT)
unnamed: D12.2, J4.S2, R20.1
unnamed: D13.1 (K), Q4.3 (D)
unnamed: D13.2 (A), R25.1
unnamed: J5.1 (VBUS), R23.1
unnamed: J5.2 (D-), R26.1
unnamed: J5.3 (D+), R24.1
unnamed: Q2.1 (G), R21.2
unnamed: Q3.1 (G), R22.2
unnamed: Q4.1 (G), R27.2
unnamed: R12.2, U3.62 (ANT_DET)
unnamed: R24.2, TP7.1, U3.29 (USB_D+)
unnamed: R26.2, TP6.1, U3.28 (USB_D-)

Notes on the sheet:
Cellular module

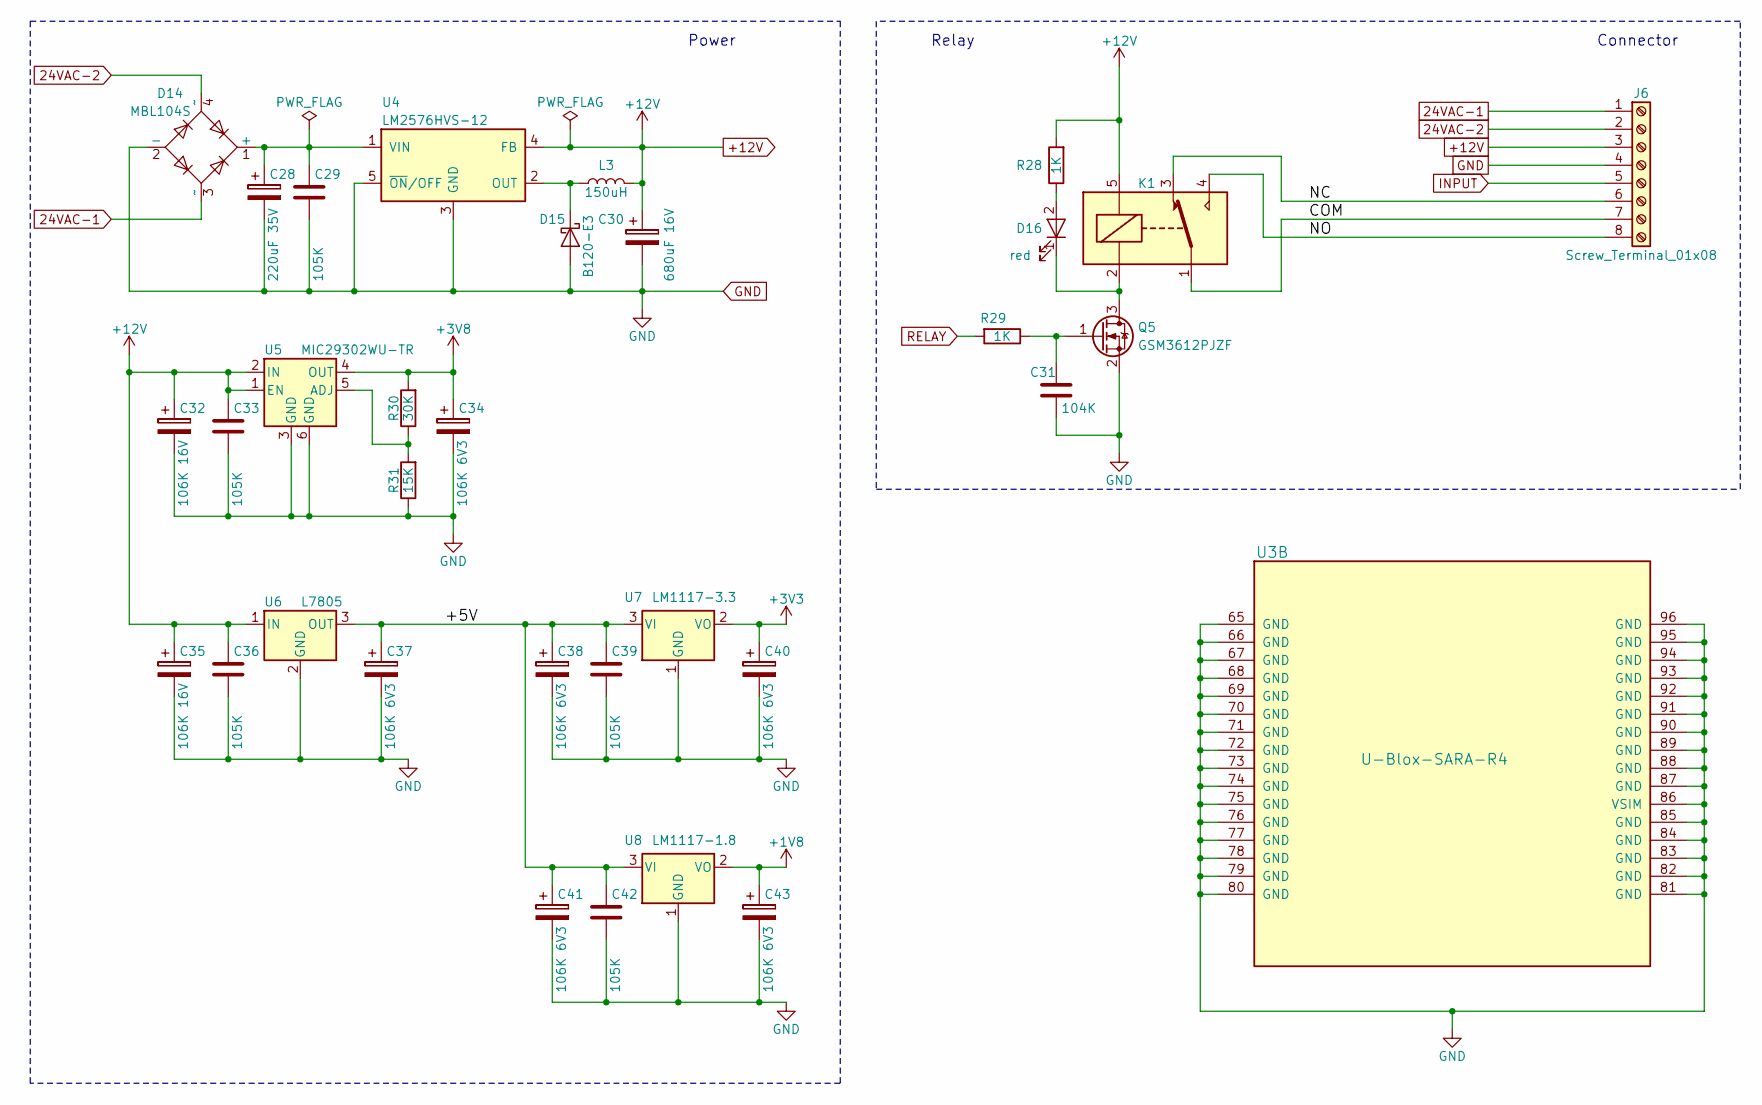
[picture p21: schematic EISScube-pw.sch, EISScube v.3.0 LTE]

Parts:
C28: 220uF 35V; CP_Elec_10x10.5
C29, C33, C36: 105K; C_1206
C30: 680uF 16V; CP_Elec_10x10.5
C31: 104K; C_0603
C32, C35: 106K 16V; CP_Tantalum_Case-B_EIA-3528-21_Reflow
C34, C37, C38, C40, C41, C43: 106K 6V3; CP_Tantalum_Case-A_EIA-3216-18_Reflow
C39, C42: 105K; C_0603
D14: MBL104S; Diode_Bridge_MBLS
D15: B120-E3; D_SMA
D16: red; LED_0603
J6: Screw_Terminal_01x08; PhoenixContact_MSTBA-G_08x5.08mm_Angled
K1: SANYOU_SRD_Form_C; Relay_SPDT_SANYOU_SRD_Series_Form_C
L3: 150uH; L_10.4x10.4_H4.8
Q5: GSM3612PJZF; SOT-23
R28, R29: 1K; R_0603
R30: 30K; R_0603
R31: 15K; R_0603
U3: U-Blox-SARA-R4; SARA-R4-96
U4: LM2576HVS-12; TO-263-5_TabPin3
U5: MIC29302WU-TR; TO-263-5_TabPin6
U6: L7805; TO-252-2
U7: LM1117-3.3; SOT-223-3_TabPin2
U8: LM1117-1.8; SOT-223-3_TabPin2

Connections:
24VAC-1: D14.3 (~~), J6.1
24VAC-2: D14.4 (~~), J6.2
+1V8: C43.1, U8.2 (VO); also elsewhere on the board
+3V8: C34.1, R30.2, U5.4 (OUT); also elsewhere on the board
+12V: C30.1, C32.1, C33.1, C35.1, C36.1, J6.3, K1.5, L3.2, R28.2, U4.4 (FB), U5.1 (EN), U5.2 (IN), U6.1 (IN)
/EISScube-pw/+5V: C37.1, C38.1, C39.1, C41.1, C42.1, U6.3 (OUT), U7.3 (VI), U8.3 (VI)
/EISScube-pw/COM: J6.7, K1.1
/EISScube-pw/NC: J6.6, K1.3
/EISScube-pw/NO: J6.8, K1.4
GND: C28.2, C29.2, C30.2, C31.2, C32.2, C33.2, C34.2, C35.2, C36.2, C37.2, C38.2, C39.2, C40.2, C41.2, C42.2, C43.2, D14.2 (-), D15.2 (A), J6.4, Q5.2 (S), R31.1, U3.65 (GND), U3.66 (GND), U3.67 (GND), U3.68 (GND), U3.69 (GND), U3.70 (GND), U3.71 (GND), U3.72 (GND), U3.73 (GND), U3.74 (GND), U3.75 (GND), U3.76 (GND), U3.77 (GND), U3.78 (GND), U3.79 (GND), U3.80 (GND), U3.81 (GND), U3.82 (GND), U3.83 (GND), U3.84 (GND), U3.85 (GND), U3.86 (VSIM), U3.87 (GND), U3.88 (GND), U3.89 (GND), U3.90 (GND), U3.91 (GND), U3.92 (GND), U3.93 (GND), U3.94 (GND), U3.95 (GND), U3.96 (GND), U4.3 (GND), U4.5 (~ON~/OFF), U5.3 (GND), U5.6 (GND), U6.2 (GND), U7.1 (GND), U8.1 (GND); also elsewhere on the board
INPUT: J6.5; also elsewhere on the board
unnamed: C28.1, C29.1, D14.1 (+), U4.1 (VIN)
unnamed: C31.1, Q5.1 (G), R29.1
unnamed: D15.1 (K), L3.1, U4.2 (OUT)
unnamed: D16.1 (K), K1.2, Q5.3 (D)
unnamed: D16.2 (A), R28.1
unnamed: R30.1, R31.2, U5.5 (ADJ)
RELAY: R29.2; also elsewhere on the board

Notes on the sheet:
Power
Relay
Connector

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
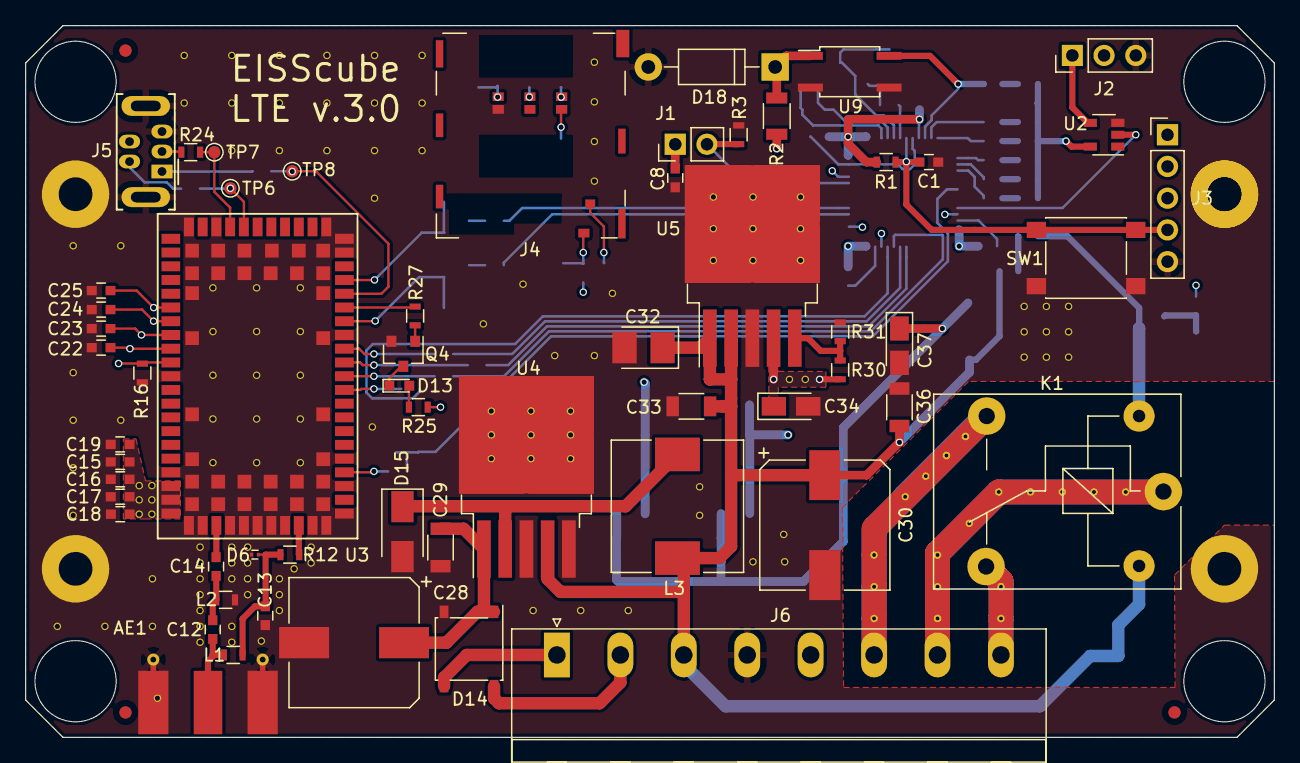
[picture p22: board EISScube v3.0 LTE.kicad_pcb from above]

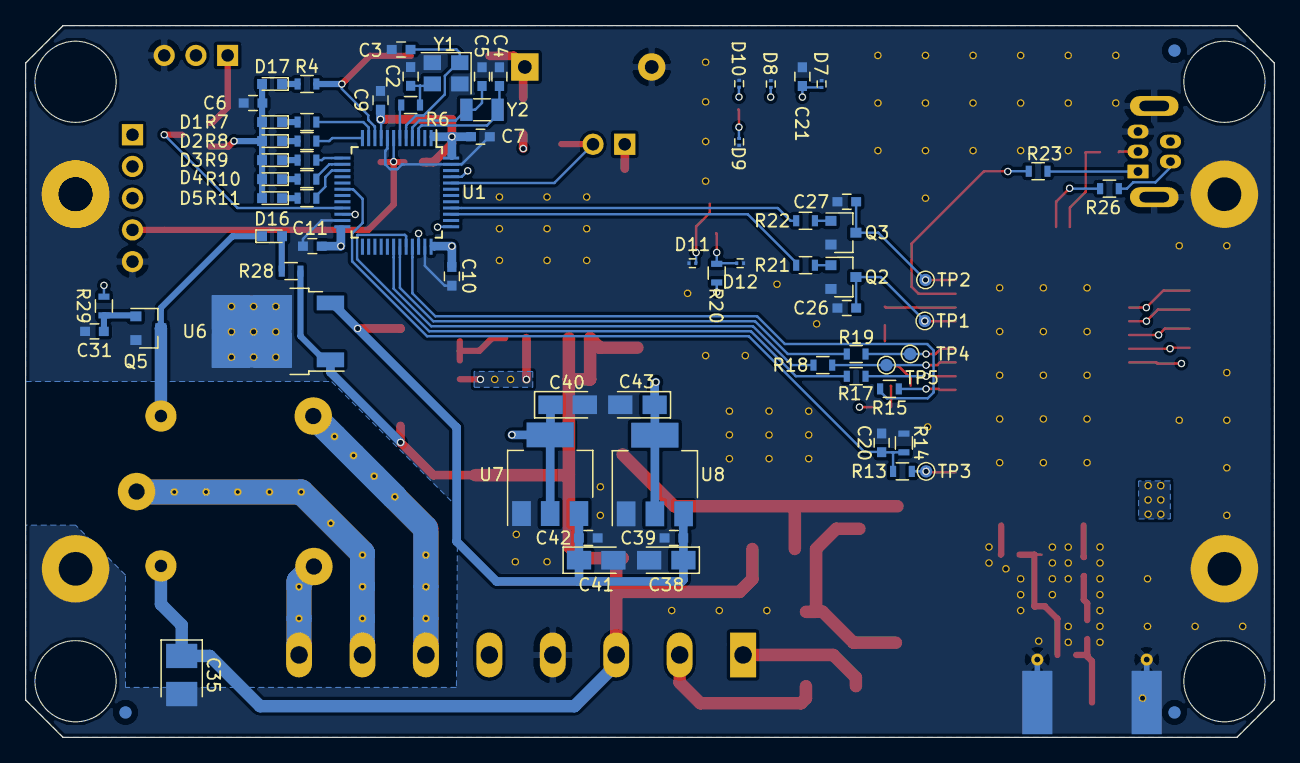
[picture p23: board EISScube v3.0 LTE.kicad_pcb from below]

Board: 4 copper layers, 100.0 x 57.0 mm, 132 parts (71 on the bottom side), 81 nets.
