ipkeys/eisscubeLTEhardware/(commit log)

2018-04-05 first version for internal review
    [EISScube v3.0 LTE-BOM.xlsx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]
2018-04-18 Changes for enclosure case
    [EISScube v3.0 LTE-BOM-case-connector.xlsx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]
2018-04-25 add visual references are called “fiducials“ on board for PnP machine
    [EISScube v3.0 LTE-B.Cu.gbr, EISScube v3.0 LTE-B.Mask.gbr, EISScube v3.0 LTE-B.Paste.gbr, EISScube v3.0 LTE-B.SilkS.gbr, EISScube v3.0 LTE-Edge.Cuts.gbr, EISScube v3.0 LTE-F.Cu.gbr, EISScube v3.0 LTE-F.Mask.gbr, EISScube v3.0 LTE-F.Paste.gbr]
2018-05-04 changes for new case RL6015
    [EISScube v3.0 LTE-B.Cu.gbr, EISScube v3.0 LTE-B.Mask.gbr, EISScube v3.0 LTE-B.Paste.gbr, EISScube v3.0 LTE-B.SilkS.gbr, EISScube v3.0 LTE-Edge.Cuts.gbr, EISScube v3.0 LTE-F.Cu.gbr, EISScube v3.0 LTE-F.Mask.gbr, EISScube v3.0 LTE-F.Paste.gbr]
2018-05-04 new spec and 3D models
    [EISScube_v3_0_LTE.FCStd, RL6015 w1 151029.STEP, RL6015.FCStd]
2018-05-07 sent to Chin-Tec
    [EISScube v3.0 LTE-B.Cu.gbr, EISScube v3.0 LTE-B.Mask.gbr, EISScube v3.0 LTE-B.Paste.gbr, EISScube v3.0 LTE-B.SilkS.gbr, EISScube v3.0 LTE-Edge.Cuts.gbr, EISScube v3.0 LTE-F.Cu.gbr, EISScube v3.0 LTE-F.Mask.gbr, EISScube v3.0 LTE-F.Paste.gbr]
2018-05-08 moved LEDs on bottom side. Created a custome bottom part of enclosure RL6015
    [EISScube v3.0 LTE-BOM-case-connector.xlsx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]
